precision-sustainable-ag/PlantMap3D-Hardware/Multi-Camera System Hardware/README.md

This directory will contain the 3D CAD for the multicamera system.
