precision-sustainable-ag/PlantMap3D-Hardware/System Management Board/SMB Power ON Flow Chart.drawio.png

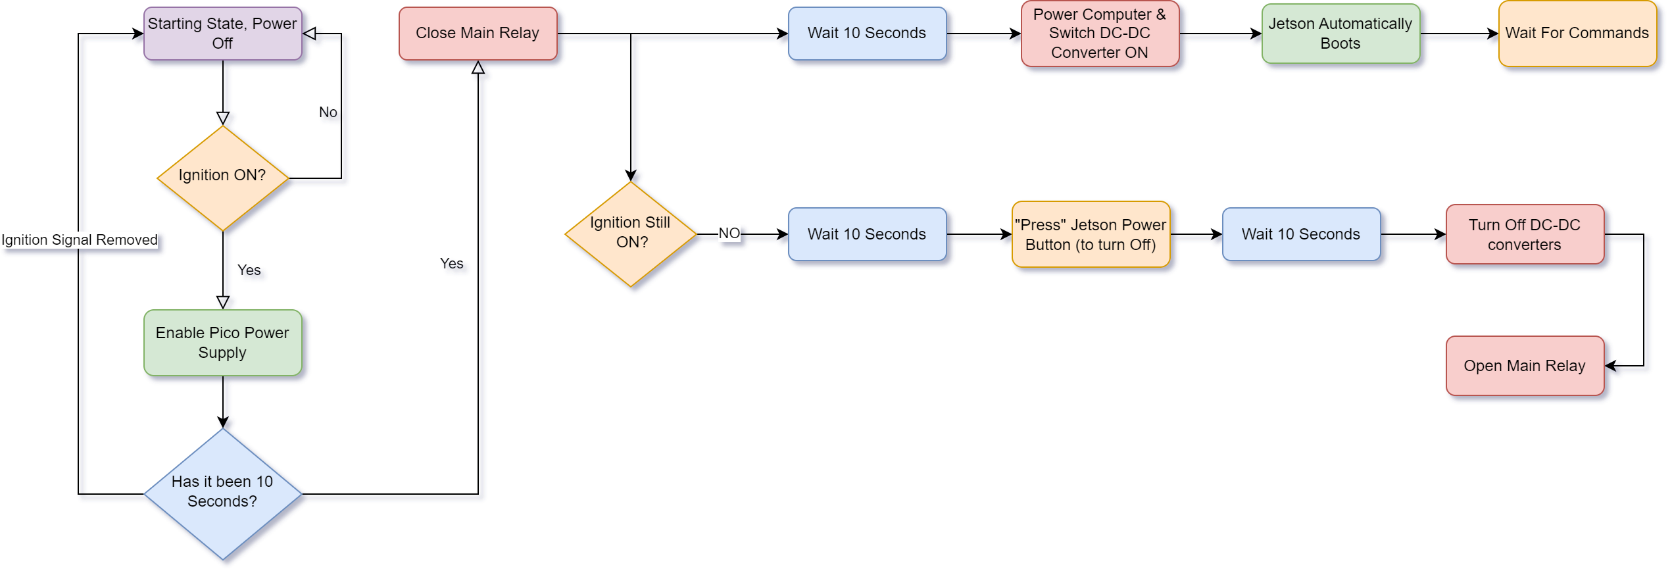
System Management Board/SMB Power ON Flow Chart.drawio.png
