precision-sustainable-ag/PlantMap3D-Hardware/System Management Board/PCB template.DXF

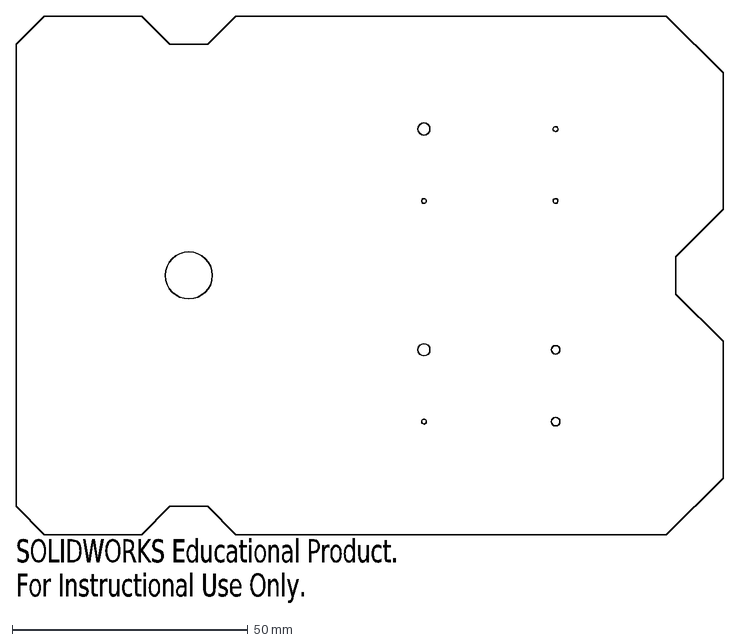
[picture p2: CAD file, 2024-04-09]
System Management Board/PCB template.DXF
SOLIDWORKS Educational Product.
For Instructional Use Only.
