precision-sustainable-ag/PlantMap3D-Hardware/System Management Board/Pico Power Stabilizer/outline template.DXF

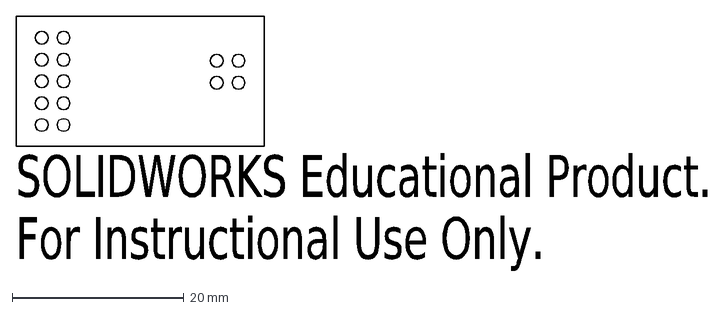
[picture p3: CAD file, 2024-12-06]
System Management Board/Pico Power Stabilizer/outline template.DXF
SOLIDWORKS Educational Product.
For Instructional Use Only.
