precision-sustainable-ag/PlantMap3D-Hardware/(list of files, cad)

Other CAD files:
System Management Board/3D CAD/I3A_STANDARD_ASM.SLDPRT
Multi-Camera System Hardware/(PSA-M063-Rev B) Enclosure Assem.SLDASM
Multi-Camera System Hardware/Brackets/Con Plate Jig.SLDASM
System Management Board/3D CAD/I7C4W008A120V-0C3-R.SLDASM
System Management Board/3D CAD/C_1210_3225Metric.SLDASM
System Management Board/3D CAD/HSOP-6J.SLDASM
Multi-Camera System Hardware/alignment jig.SLDASM
System Management Board/3D CAD/PinSocket_2x05_P2.54mm_Vertical.SLDASM
System Management Board/3D CAD/PinHeader_2x20_P2.54mm_Vertical.SLDASM
System Management Board/3D CAD/User Library-EE2-5NU.SLDASM
System Management Board/3D CAD/XG4A-4035--3DModel-STEP-273799.SLDASM
System Management Board/3D CAD/SOT-23.SLDASM
System Management Board/3D CAD/PinHeader_2x06_P2.54mm_Vertical.SLDASM
System Management Board/3D CAD/CUI_DEVICES_PJ-063BH.SLDASM
System Management Board/3D CAD/RES_3540_TEC.SLDASM
System Management Board/3D CAD/I3A4W008A033V-001-R.SLDASM
System Management Board/3D CAD/R_1206_3216Metric.SLDASM
System Management Board/3D CAD/D_SOD-123F.SLDASM
System Management Board/3D CAD/PinSocket_1x20_P2.54mm_Vertical.SLDASM
System Management Board/3D CAD/PinHeader_1x02_P2.54mm_Vertical.SLDASM
System Management Board/3D CAD/D_SMA.SLDASM
System Management Board/3D CAD/PinHeader_1x20_P2.54mm_Vertical.SLDASM
System Management Board/3D CAD/C_1206_3216Metric.SLDASM
System Management Board/3D CAD/50A relay.SLDASM
System Management Board/3D CAD/POWERDI5_DIO.SLDASM
System Management Board/3D CAD/User Library-ATO-ATC STANDARD BLADE FUSE.SLDASM
System Management Board/3D CAD/PinHeader_1x04_P2.54mm_Vertical.SLDASM
System Management Board/3D CAD/Relay_DPDT_Schrack-RT2-FormC_RM5mm.SLDASM
System Management Board/3D CAD/LED_1206_3216Metric.SLDASM
System Management Board/3D CAD/Universal Car Fuse Holder PCB v1.SLDASM
System Management Board/3D CAD/TSSOP-16_4.4x5mm_P0.65mm.SLDASM
System Management Board/Pico Power Stabilizer/Production Tooling/PinSocket_2x02_P2.54mm_Vertical_SMD.SLDASM
System Management Board/3D CAD/SC0915.SLDASM
System Management Board/3D CAD/Fuse_1206_3216Metric.SLDASM
System Management Board/Pico Power Stabilizer/Production Tooling/Pico Power Stabilizer.SLDASM
System Management Board/3D CAD/TL3305BF260QG.SLDASM
System Management Board/3D CAD/CP_Elec_10x12.6.SLDASM
System Management Board/Pico Power Stabilizer/Production Tooling/PinSocket_2x05_P2.54mm_Vertical_SMD.SLDASM
System Management Board/Pico Power Stabilizer/Production Tooling/R_0603_1608Metric.SLDASM
System Management Board/Pico Power Stabilizer/Production Tooling/PinHeader_2x02_P2.54mm_Vertical_SMD.SLDASM
System Management Board/Pico Power Stabilizer/Production Tooling/PinHeader_2x05_P2.54mm_Vertical_SMD.SLDASM
System Management Board/Pico Power Stabilizer/Production Tooling/jig Asm.SLDASM
System Management Board/Pico Power Stabilizer/Production Tooling/C_1210_3225Metric.SLDASM
System Management Board/Pico Power Stabilizer/Production Tooling/LED_0603_1608Metric.SLDASM
Mono Camera System Hardware/Oak-d CM4-POE Calibration Adapter Bracket.SLDPRT
Multi-Camera System Hardware/(PSA-0469-Rev B) Heatsink.STEP
Multi-Camera System Hardware/Brackets/(PSA-1318-Rev B) Backing Clamp Short.STEP
Part Manufacturing Files/10g switch hold down bracket.3MF
System Management Board/3D CAD/(PSA-M018-Rev A) System Management Board.SLDPRT
System Management Board/Pico Power Stabilizer/Pico Power Stabilizer.step
System Management Board/Pico Power Stabilizer/Production Tooling/PinHeader_2x02_P254mm_Vertical_SMD.SLDPRT
Multi-Camera System Hardware/(PSA-0105) Enclosure.SLDPRT
Multi-Camera System Hardware/Brackets/(PSA-1317-Rev B) Backing Clamp Long.STEP
Part Manufacturing Files/Lower Switch Mount.3MF
System Management Board/Pico Power Stabilizer/Production Tooling/Pico Power Stabilizer_pad_32.SLDPRT
Part Manufacturing Files/Peplink 42G Adapter.STEP
System Management Board/3D CAD/TSSOP_16_44x5mm_P065mm.SLDPRT
System Management Board/Pico Power Stabilizer/Production Tooling/Pico Power Stabilizer_pad_198.SLDPRT
Multi-Camera System Hardware/(PSA-1316-Rev A) Connector Plate.STEP
Part Manufacturing Files/Switch Bracket.3MF
System Management Board/Pico Power Stabilizer/Production Tooling/Pico Power Stabilizer_pad_9.SLDPRT
Multi-Camera System Hardware/(PSA-1320-Rev A) Heatsink Template.STEP
Part Manufacturing Files/Alignment jig.3MF
System Management Board/3D CAD/SC0915-13.SLDPRT
System Management Board/Pico Power Stabilizer/Production Tooling/Pico Power Stabilizer_pad_89.SLDPRT
Multi-Camera System Hardware/(PSA-0292-Rev A) Connector Plate Gasket.SLDPRT
Multi-Camera System Hardware/Brackets/(PSA-0749-Rev) Indicator Light Bracket.STEP
Part Manufacturing Files/Heatsink 266AS.STEP
System Management Board/3D CAD/LED_1206_3216Metric-7.SLDPRT
System Management Board/Pico Power Stabilizer/Production Tooling/Pico Power Stabilizer_track_4.SLDPRT
Multi-Camera System Hardware/(PSA-1319-Rev A) Connector Plate Template.STEP
Multi-Camera System Hardware/Brackets/(PSA-0754-Rev A) Din Rail Cable Clip.STEP
Part Manufacturing Files/Enclosure Drill Template.3MF
System Management Board/Pico Power Stabilizer/Production Tooling/Pico Power Stabilizer_pad_134.SLDPRT
Multi-Camera System Hardware/(PSA-0110-Rev B) Heat Spreader.SLDPRT
System Management Board/Pico Power Stabilizer/Production Tooling/Pico Power Stabilizer_pad_160.SLDPRT
Multi-Camera System Hardware/(PSA-0015) Jetson Dev Kit.SLDPRT
Multi-Camera System Hardware/Brackets/Din Rail Cable Clip.STEP
System Management Board/3D CAD/System Management Board_PCB.SLDPRT
System Management Board/Pico Power Stabilizer/Production Tooling/Pico Power Stabilizer_pad_171.SLDPRT
Multi-Camera System Hardware/(PSA-0746-Rev A) Manufactured Backing Plate.STEP
Multi-Camera System Hardware/Brackets/Con Plate Jig Leg.STEP
System Management Board/3D CAD/XG4A_4035.SLDPRT
System Management Board/Pico Power Stabilizer/Production Tooling/Pico Power Stabilizer_pad_81.SLDPRT
Multi-Camera System Hardware/(PSA-0703) POE Switch.SLDPRT
Multi-Camera System Hardware/Brackets/Jig Base.STEP
System Management Board/Pico Power Stabilizer/Production Tooling/Pico Power Stabilizer_pad_7.SLDPRT
Multi-Camera System Hardware/Brackets/dupont header clip.STEP
System Management Board/3D CAD/PinSocket_1x20_P254mm_Vertical.SLDPRT
System Management Board/Pico Power Stabilizer/Production Tooling/Pico Power Stabilizer_pad_102.SLDPRT
Multi-Camera System Hardware/(PSA-0720-Rev A) Switch Angle Bracket.SLDPRT
System Management Board/Pico Power Stabilizer/Production Tooling/Pico Power Stabilizer_pad_132.SLDPRT
Multi-Camera System Hardware/(PSA-0382) DIN Rail.SLDPRT
System Management Board/Pico Power Stabilizer/Production Tooling/Pico Power Stabilizer_pad_140.SLDPRT
Multi-Camera System Hardware/Laser Cut Mounting Plate.STEP
System Management Board/3D CAD/187CBA5A-D168-4B29-A226-42CC7D4E3C29.SLDPRT
System Management Board/Pico Power Stabilizer/Production Tooling/R_0603_1608Metric-1.SLDPRT
Multi-Camera System Hardware/2.5GBE POE SW Angle Bracket.STEP
System Management Board/Pico Power Stabilizer/Production Tooling/Pico Power Stabilizer_pad_169.SLDPRT
Multi-Camera System Hardware/BBv3 Connector Plate Gasket.STEP
System Management Board/3D CAD/PinHeader_1x04_P254mm_Vertical.SLDPRT
System Management Board/Pico Power Stabilizer/Production Tooling/Pico Power Stabilizer_pad_63.SLDPRT
Multi-Camera System Hardware/RF174-01RP1-05BJ3-0305.SLDPRT
System Management Board/3D CAD/C_1206_3216Metric-6.SLDPRT
System Management Board/Pico Power Stabilizer/Production Tooling/Pico Power Stabilizer_pad_57.SLDPRT
Multi-Camera System Hardware/PCB template.SLDPRT
System Management Board/3D CAD/R_1206_3216Metric-2.SLDPRT
System Management Board/Pico Power Stabilizer/Production Tooling/Pico Power Stabilizer_pad_98.SLDPRT
Multi-Camera System Hardware/Heatsink 165AS.SLDPRT
System Management Board/Pico Power Stabilizer/Production Tooling/Pico Power Stabilizer_pad_93.SLDPRT
System Management Board/Pico Power Stabilizer/Production Tooling/Pico Power Stabilizer_pad_42.SLDPRT
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
