precision-sustainable-ag/PlantMap3D-Hardware/Part Manufacturing Files/README.md

This directory will contain ready to use 2D and 3D manufacturing files, primarly for 3D printed and 2D routed parts.
