precision-sustainable-ag/PlantMap3D-Hardware/(threads)

Thread 2 (2024-03-18):

SIM Card Became Disconnected from PepWave Modem

alexrallen, 2024-03-18:
We observed an issue on the lake wheeler deployment where the pepwave stopped recognizing that a SIM card was connected.

A software reset was attempted within the web interface but that did not help.

The SIM card was then physically removed and reinstalled. After this the card was recognized again.

Filing this bug as a record of this issue, it is likely not actionable and we will not worry about it unless it reproduces again.

alexrallen, 2024-03-18:
Mark, you can close this as wontfix for now if you desire.

Closed 2024-03-19.

Thread 3 (2024-03-18):

Add RTC Batteries to Jetsons

alexrallen, 2024-03-18:
As of now, if the Jetson is powered off and does not have an active Internet connection at boot it fails to keep track of the current time.

This is important for time-stamping collected data and logs when under a flaky connection.

We can purchase a battery to be added to header "RTC_BATT" on the devkit board.

alexrallen, 2024-03-18:
I will identify a battery for purchase.

alexrallen, 2024-03-19:
@mtfunder This would work nicely (I don't recall how many Jetsons we have - pick your quantity based on your discretion, I linked a 10pk)

Rome Tech BIOS CMOS RTC Battery for Dell Alienware Alpha & Alienware Steam Machine Yellow Light Fix - CR2032CL-23-2 (10-Pack) https://a.co/d/dBacpJK

mtfunder, 2024-09-22:
As an update:

We ordered 30 of the above linked batteries but unfortunately the connection did not match up as expected.

Other options need to be investigated.

mtfunder, 2024-10-10:
Have not made progress on adding RTC for the AGX Orin carrier board in the multicam system.

This is the task for the Rafiki system: https://github.com/precision-sustainable-ag/Rafiki/issues/10

mtfunder, 2024-10-10:
I found this https://www.amazon.com/Rome-Tech-CMOS-Battery-Latitude/dp/B0BVN1NPJ2

from https://forums.developer.nvidia.com/t/rtc-clock-battery-for-the-orin-dev-kit/220939'

I think that may be the type for the AGX CB at least.

Closed 2025-02-24.

Thread 5 (2024-09-20):

Design new bracket for cellular modem

mtfunder, 2024-09-20:
**What's wrong**
- For PM3D multi installs we have used the L-bracket that is supplied with the cellular modem to mount it to the sprayer. However, this bracket is limited din the size of member it can be bolted to, and it has been determined it is not sturdy enough and may break over time due to fatigue from repeated bouncing of the modem.

**What done looks like**
- A complete part entry in PartsBox with a 3D .STEP files and a pdf drawing showing important dimensions.
- Cost estimate for 20 pcs from SendCutSend or OshPark.
- Source any additional hardware, like the screws that attach to the back of the modem. (The ones supplies are low quality and probably the wrong length.

**Additional Information**
- Design the bracket from stainless steel or powered coated aluminum or similar (heavy corrosion environment)
- 1/8" SS or 1/4" Al is probably sufficient
- Co-ordinate with installer to determine likely U-bolt sizes needed.

rbabcoc, 2025-01-27:
New bracket has been designed, ordered, delivered, tested, and packed for installer.

Thread 6 (2024-09-20):

External status light on CCM

mtfunder, 2024-09-20:
**What's wrong**
- Without opening the enclosure or checking to see if the Wi-Fi network is broadcasting, there isn't an easy way to tell if the system is currently powered on or running.

**What done looks like**
- A design and hardware selection for adding this light.
- All parts added to PartsBox
- Confluence page describing how it will work and how to install.
- Confirmation from the @alexrallen that embedded can add this feature on the software side.

**Additional Information**
- Be sure the external hardware is IP67 or better.
- Bright enough to see in daylight from the tractor cab.
- @Djyankencsu can help with figuring out how the SMB Pico could control the LED.
- Investigate if the SMB Aux header can be used for this.

cwnicho2, 2024-10-17:
**Best IP67 options so far**
https://veise2008.en.made-in-china.com/product/IZyAskMlZJGP/China-IP69K-Waterproof-Beacon-Warning-Lamp-Light-for-Emergency-Vehicle.html

https://www.grainger.com/product/ECCO-Beacon-Light-Flashing-Beacon-406A62

**My Favorite choice but its IP65 only**
https://shop.industrialemart.com/pdf/MS56M.pdf

cwnicho2, 2024-12-09:
See parts box project https://partsbox.com/psa/project/6981cejp9aky0ak03n6tyq2z8b/bom for the partslist

Closed 2025-02-21.

Thread 7 (2024-09-23):

Specify new parts for camera cable enhancement

mtfunder, 2024-09-23:
## Rationale ##
- The current way we manufacture the camera cables is somewhat cumbersome and has led to many defective connections.

## What done looks like ##
- Select a line of standard-length cables that will meet the needs for planned installations.
- Select the bulkhead connectors that will be used on the CCM side.
- Add all new parts to Partsbox.

## Stakeholders / Contacts ##
- @mtfunder

## Additional Information ##
- We may look into female to male extension cables as well.
- Should be outdoor rated (UV /water/ chemical exposure).

mtfunder, 2024-09-23:
This is looking to be a bit painful. There are not that many suppliers of these cable assemblies that actually keep them in stock. And those that do may not have enough for our needs.

Further, 15 meters is the longest common length, which would require an extension cable in many installs.

Closed 2025-02-21.

Thread 8 (2024-09-23):

Modify Modular Connector Plate design for new camera cable connectors

mtfunder, 2024-09-23:
## Rationale ##
- The connector plate will need to be re-designed to fit the new M12 X-code connectors selected here: https://github.com/precision-sustainable-ag/PlantMap3D-Hardware/issues/7
- Also, the GPS connector holes should be added to the CAD so they do not need to be manually drilled.

## What done looks like ##
- CAD file and price quote uploaded to PartsBox, added to project.

## Stakeholders / Contacts ##
- @mtfunder

## Additional Information ##
- Use new BB mounting hole pattern

Closed 2025-02-24.

Thread 9 (2024-09-23):

Create procedure for tightening / installing M12 cables correctly

mtfunder, 2024-09-23:
## Rationale ##
- We have had issues with eh consistency of installed M12 connections on the Pm3D multi system and elsewhere.
- This has resulted in some connection failures, particularly camera cables.

## What done looks like ##
- A basic procedure for installing the connectors written on Confluence.
- Any tools specified added to PartsBox.

## Stakeholders / Contacts ##
- @mtfunder
- @rbabcoc

## Additional Information ##
- See what the industry standard is, some kind of torque wrench?

mtfunder, 2024-09-23:
This looks like a decent tool to try out: https://www.digikey.com/en/products/detail/weidm%C3%BCller/1920000000/3994560

Notably this one will work with round connectors.

Thread 14 (2024-10-04):

[PO]: Custom Heatsink Order

mtfunder, 2024-10-04:
Place an order with sales@heatsinkonline.com for 10 more of the same heatsink we ordered with them last time.

There is an existing email thread @mtfunder can forward you.

You will need a quote, however this will be well under $5K so you do not need a formal PO.

##Partsbox Link##

https://partsbox.com/psa/parts/5g5nmzmda6kacbr57mfy0sk6aq

kldriver, 2024-10-17:
@mtfunder If you send me the email thread for the exact heatsink, I can get things moving on this purchase

mtfunder, 2024-11-04:
@kldriver I replied and CCd you to the email.

Closed 2024-12-10.

Thread 16 (2024-11-04):

Develop a Deployable Camera Flash Controller Unit

cwnicho2, 2024-11-04:
## Rationale ##
- The previous implementation is simple, and works as intended but is a prototype quality device

## What done looks like ##
- Electronics assembly robust and repeatable [consider making a PCB]
- Housing meets the weatherproofing expectations of the benchbot system [IP67 typically]
- All new parts added to PartsBox
- Confluence page updated to reflect the design decisions.

## Stakeholders / Contacts ##
- @mtfunder

Confluence:
https://precision-sustainable-ag.atlassian.net/wiki/spaces/HE/pages/771096604/Camera+Flash+Handler+Board

Thread 17 (2025-04-28):

SMBV0.3 Input Voltage Bug

cwnicho2, 2025-04-28:
**Describe the bug**
When testing the system management board [SMBV0.3] at higher supply voltage 24V, the system was not able to properly boot. The system was believed to be tolerant of higher input voltages and this was discovered by accident.

**To Reproduce**
Steps to reproduce the behavior:
1. Connect J1 and the keyswitch trigger to the the SMB using a DC power supply
2. Set the supply voltage to 24V
3. Torn on the output of the power supply and observe the SMB behavior

**Expected behavior**
The SMB should be tolerant of the higher input voltage

**Additional context**
There is a cable made for testing the SMB with the DC power supply available in the lab space. I recomend testing a series of voltages from 12v onward to see at what voltage the behavior destabilizes

Thread 18 (2025-04-28):

Future SMB revisions

cwnicho2, 2025-04-28:
## Rationale ##
- These are improvements/changes that can be made that didn't make it into V0.3

## What done looks like ##
- Update KiCad files
- Update Partsbox SMB project: Designators, BOM, etc

## Specific Details ##
- There are 1210 and 1206 footprints for the same capacaitor smd these can be consolidated into one single size. This apparantly is an artifact from a previous supply chain issue
-  Remove all instances of the EE-2NU signal relay being used so that is never accidentally populated
-  The most recent branch is relay stick fix, we should make clear which version future engineers should work/fork from
