precision-sustainable-ag/PlantMap3D-Hardware/Part Manufacturing Files/Heatsink 266AS Tapped Hole Locations.pdf

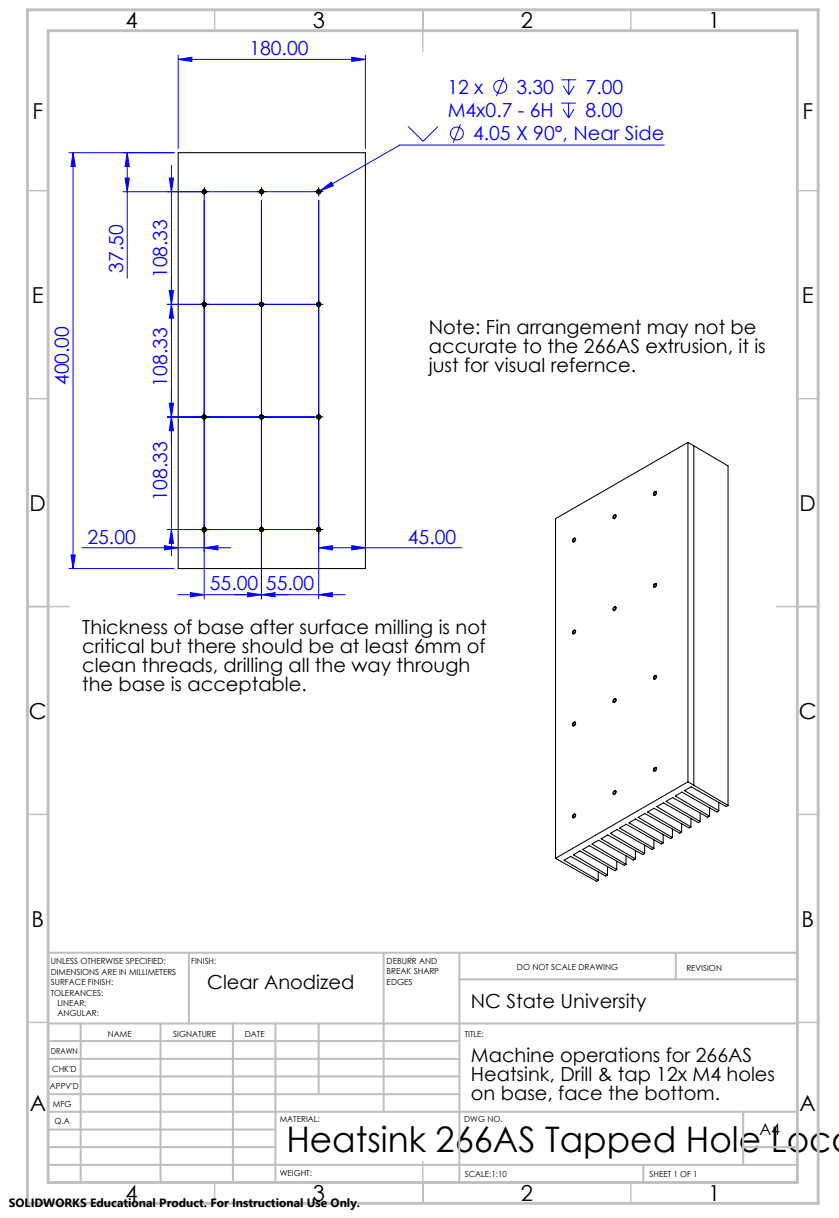
[picture p6: page 1]
M4x0.7 - 6H 8.00 4.05 X 90°, Near Side; Clear Anodized; FINISH:; DEBURR AND; BREAK SHARP; DO NOT SCALE DRAWING; REVISION; SCALE:1:10; SHEET 1 OF 1

Note: Fin arrangement may not be
accurate to the 266AS extrusion, it is
just for visual refernce.

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

UNLESS OTHERWISE SPECIFIED:
DIMENSIONS ARE IN MILLIMETERS
SURFACE FINISH:
TOLERANCES:
LINEAR:
ANGULAR:

NC State University

NAME | SIGNATURE | DATE | | | | TITLE: Machine operations for 266AS Heatsink, Drill & tap 12x M4 holes on base, face the bottom.

DRAWN
CHK'D
APPV'D
MFG
Q.A | | | | MATERIAL: | DWG NO. | A4

Heatsink 266AS Tapped Hole Locations

SOLIDWORKS Educational Product. For Instructional Use Only.
