precision-sustainable-ag/PlantMap3D-Hardware/System Management Board/System Management Board.pdf

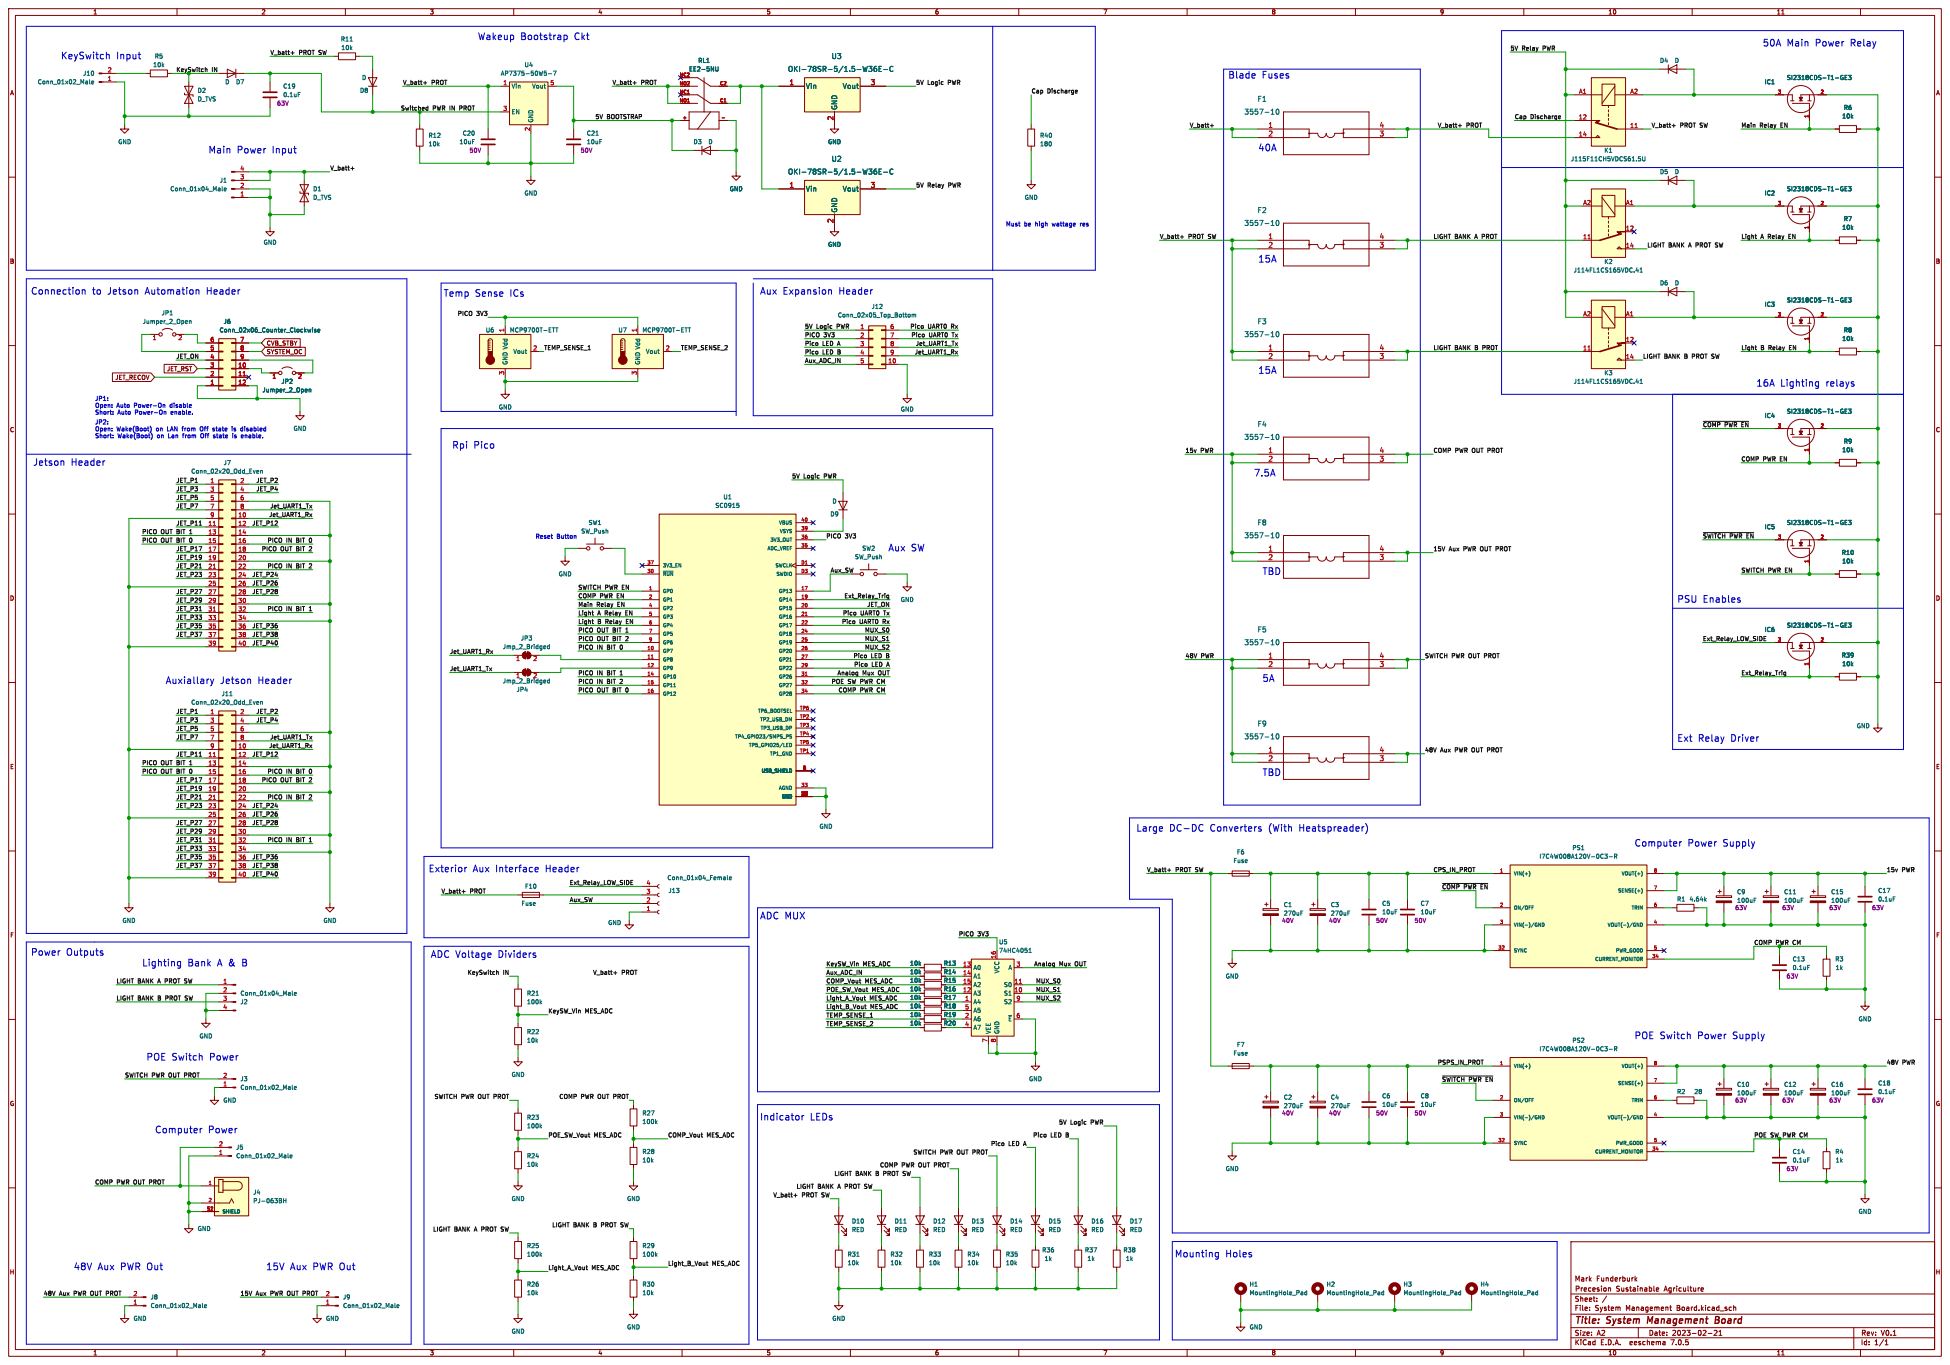
[picture p7: page 1]

2 Vout 3 GND GND GND U3 OKI-78SR-5/1.5-W36E-C

Switched PWR IN PROT

~{COMP PWR EN} LIGHT BANK A PROT SW

3 U7 MCP9700T-ETT SW1 SW_Push GND
JP2: Open: Wake(Boot) on LAN from Off state is disabled Short: Wake(Boot) on Lan from Off state is enable. Computer Power

LIGHT BANK B PROT SW

COMP PWR OUT PROT

JET_P11 PICO OUT BIT 0 PICO OUT BIT 1

15V Aux PWR OUT PROT

PICO IN BIT 2 PICO OUT BIT 0

~{COMP PWR EN} 48V Aux PWR OUT PROT COMP_Vout MES_ADC

Large DC-DC Converters (With Heatspreader)

Exterior Aux Interface Header

MUX_S1 MUX_S0 Analog Mux OUT SWITCH PWR OUT PROT

LIGHT BANK A PROT SW

SWITCH PWR OUT PROT

POE SW PWR CM

48V Aux PWR OUT PROT
