precision-sustainable-ag/PlantMap3D-Hardware/Part Manufacturing Files/Enclosure Drill Template.pdf

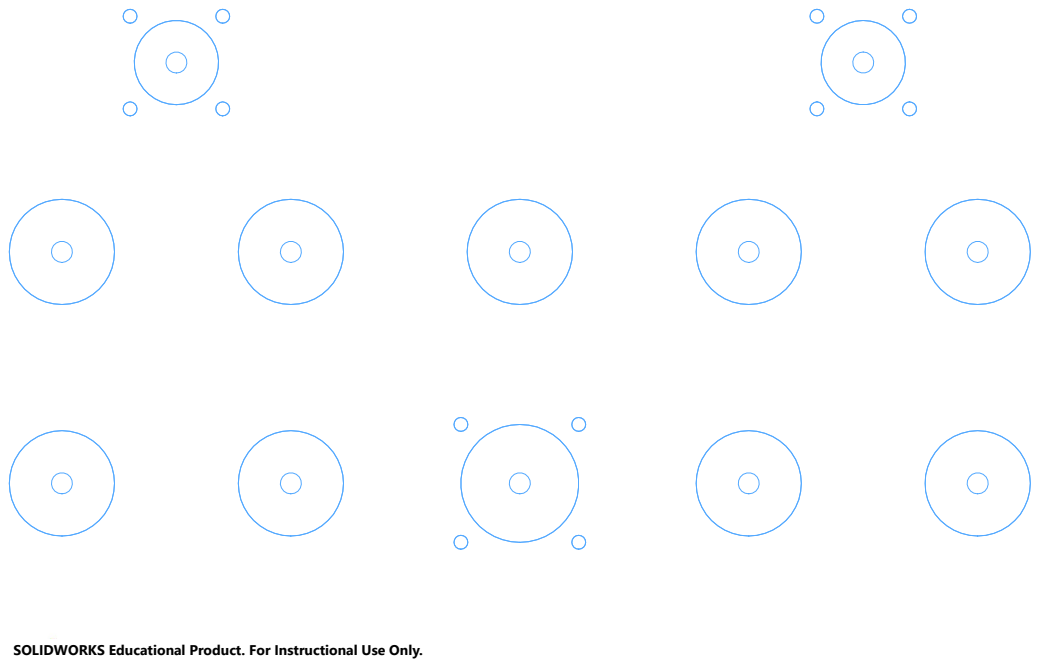
[picture p8: page 1]

SOLIDWORKS Educational Product. For Instructional Use Only.
