precision-sustainable-ag/PlantMap3D-Hardware/System Management Board/Pico Power Stabilizer/Pico Power Stabilizer.kicad_pcb

## KiCad design System Management Board/Pico Power Stabilizer/Pico Power Stabilizer.kicad_pcb (2024-12-06)

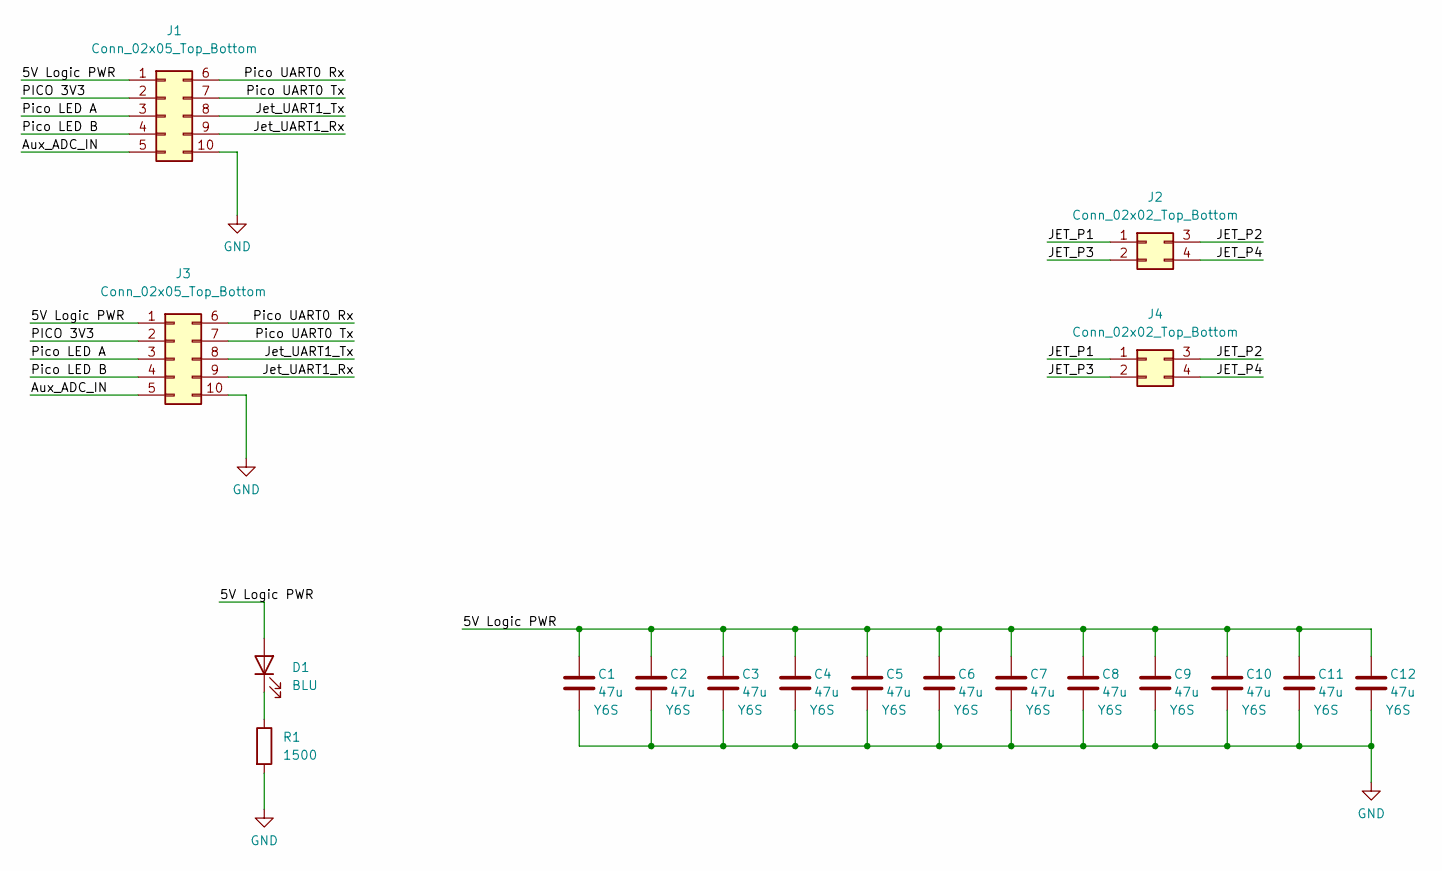
[picture p9: schematic Pico Power Stabilizer.kicad_sch]

Parts:
C1, C2, C3, C4, C5, C6, C7, C8, C9, C10, C11, C12: 47u; C_1210_3225Metric
D1: BLU; LED_0603_1608Metric
J1: Conn_02x05_Top_Bottom; PinHeader_2x05_P2.54mm_Vertical_SMD
J2: Conn_02x02_Top_Bottom; PinHeader_2x02_P2.54mm_Vertical_SMD
J3: Conn_02x05_Top_Bottom; PinSocket_2x05_P2.54mm_Vertical_SMD
J4: Conn_02x02_Top_Bottom; PinSocket_2x02_P2.54mm_Vertical_SMD
R1: 1500; R_0603_1608Metric

Connections:
/5V Logic PWR: C1.1, C2.1, C3.1, C4.1, C5.1, C6.1, C7.1, C8.1, C9.1, C10.1, C11.1, C12.1, D1.2 (A), J1.1, J3.1
/Aux_ADC_IN: J1.5, J3.5
/JET_P1: J2.1, J4.1
/JET_P2: J2.3, J4.3
/JET_P3: J2.2, J4.2
/JET_P4: J2.4, J4.4
/Jet_UART1_Rx: J1.9, J3.9
/Jet_UART1_Tx: J1.8, J3.8
/PICO 3V3: J1.2, J3.2
/Pico LED A: J1.3, J3.3
/Pico LED B: J1.4, J3.4
/Pico UART0 Rx: J1.6, J3.6
/Pico UART0 Tx: J1.7, J3.7
GND: C1.2, C2.2, C3.2, C4.2, C5.2, C6.2, C7.2, C8.2, C9.2, C10.2, C11.2, C12.2, J1.10, J3.10, R1.2
unnamed: D1.1 (K), R1.1

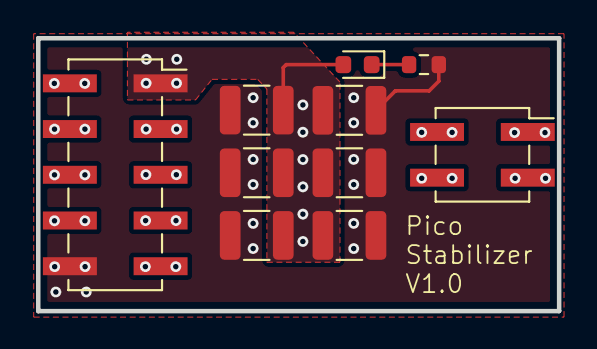
[picture p10: board Pico Power Stabilizer.kicad_pcb from above]

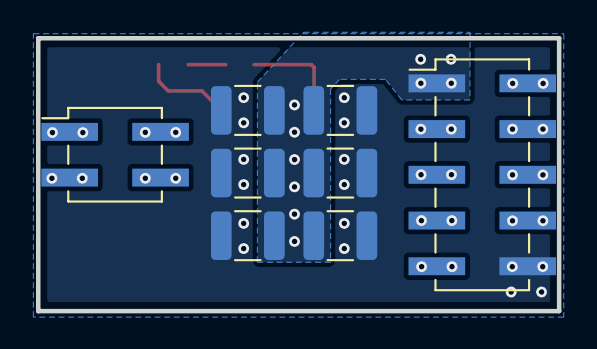
[picture p11: board Pico Power Stabilizer.kicad_pcb from below]

Board: 2 copper layers, 28.9 x 15.2 mm, 18 parts (8 on the bottom side), 15 nets.
