precision-sustainable-ag/PlantMap3D-Hardware/System Management Board/System Management Board.kicad_pcb

## KiCad design System Management Board/System Management Board.kicad_pcb (2024-11-21)

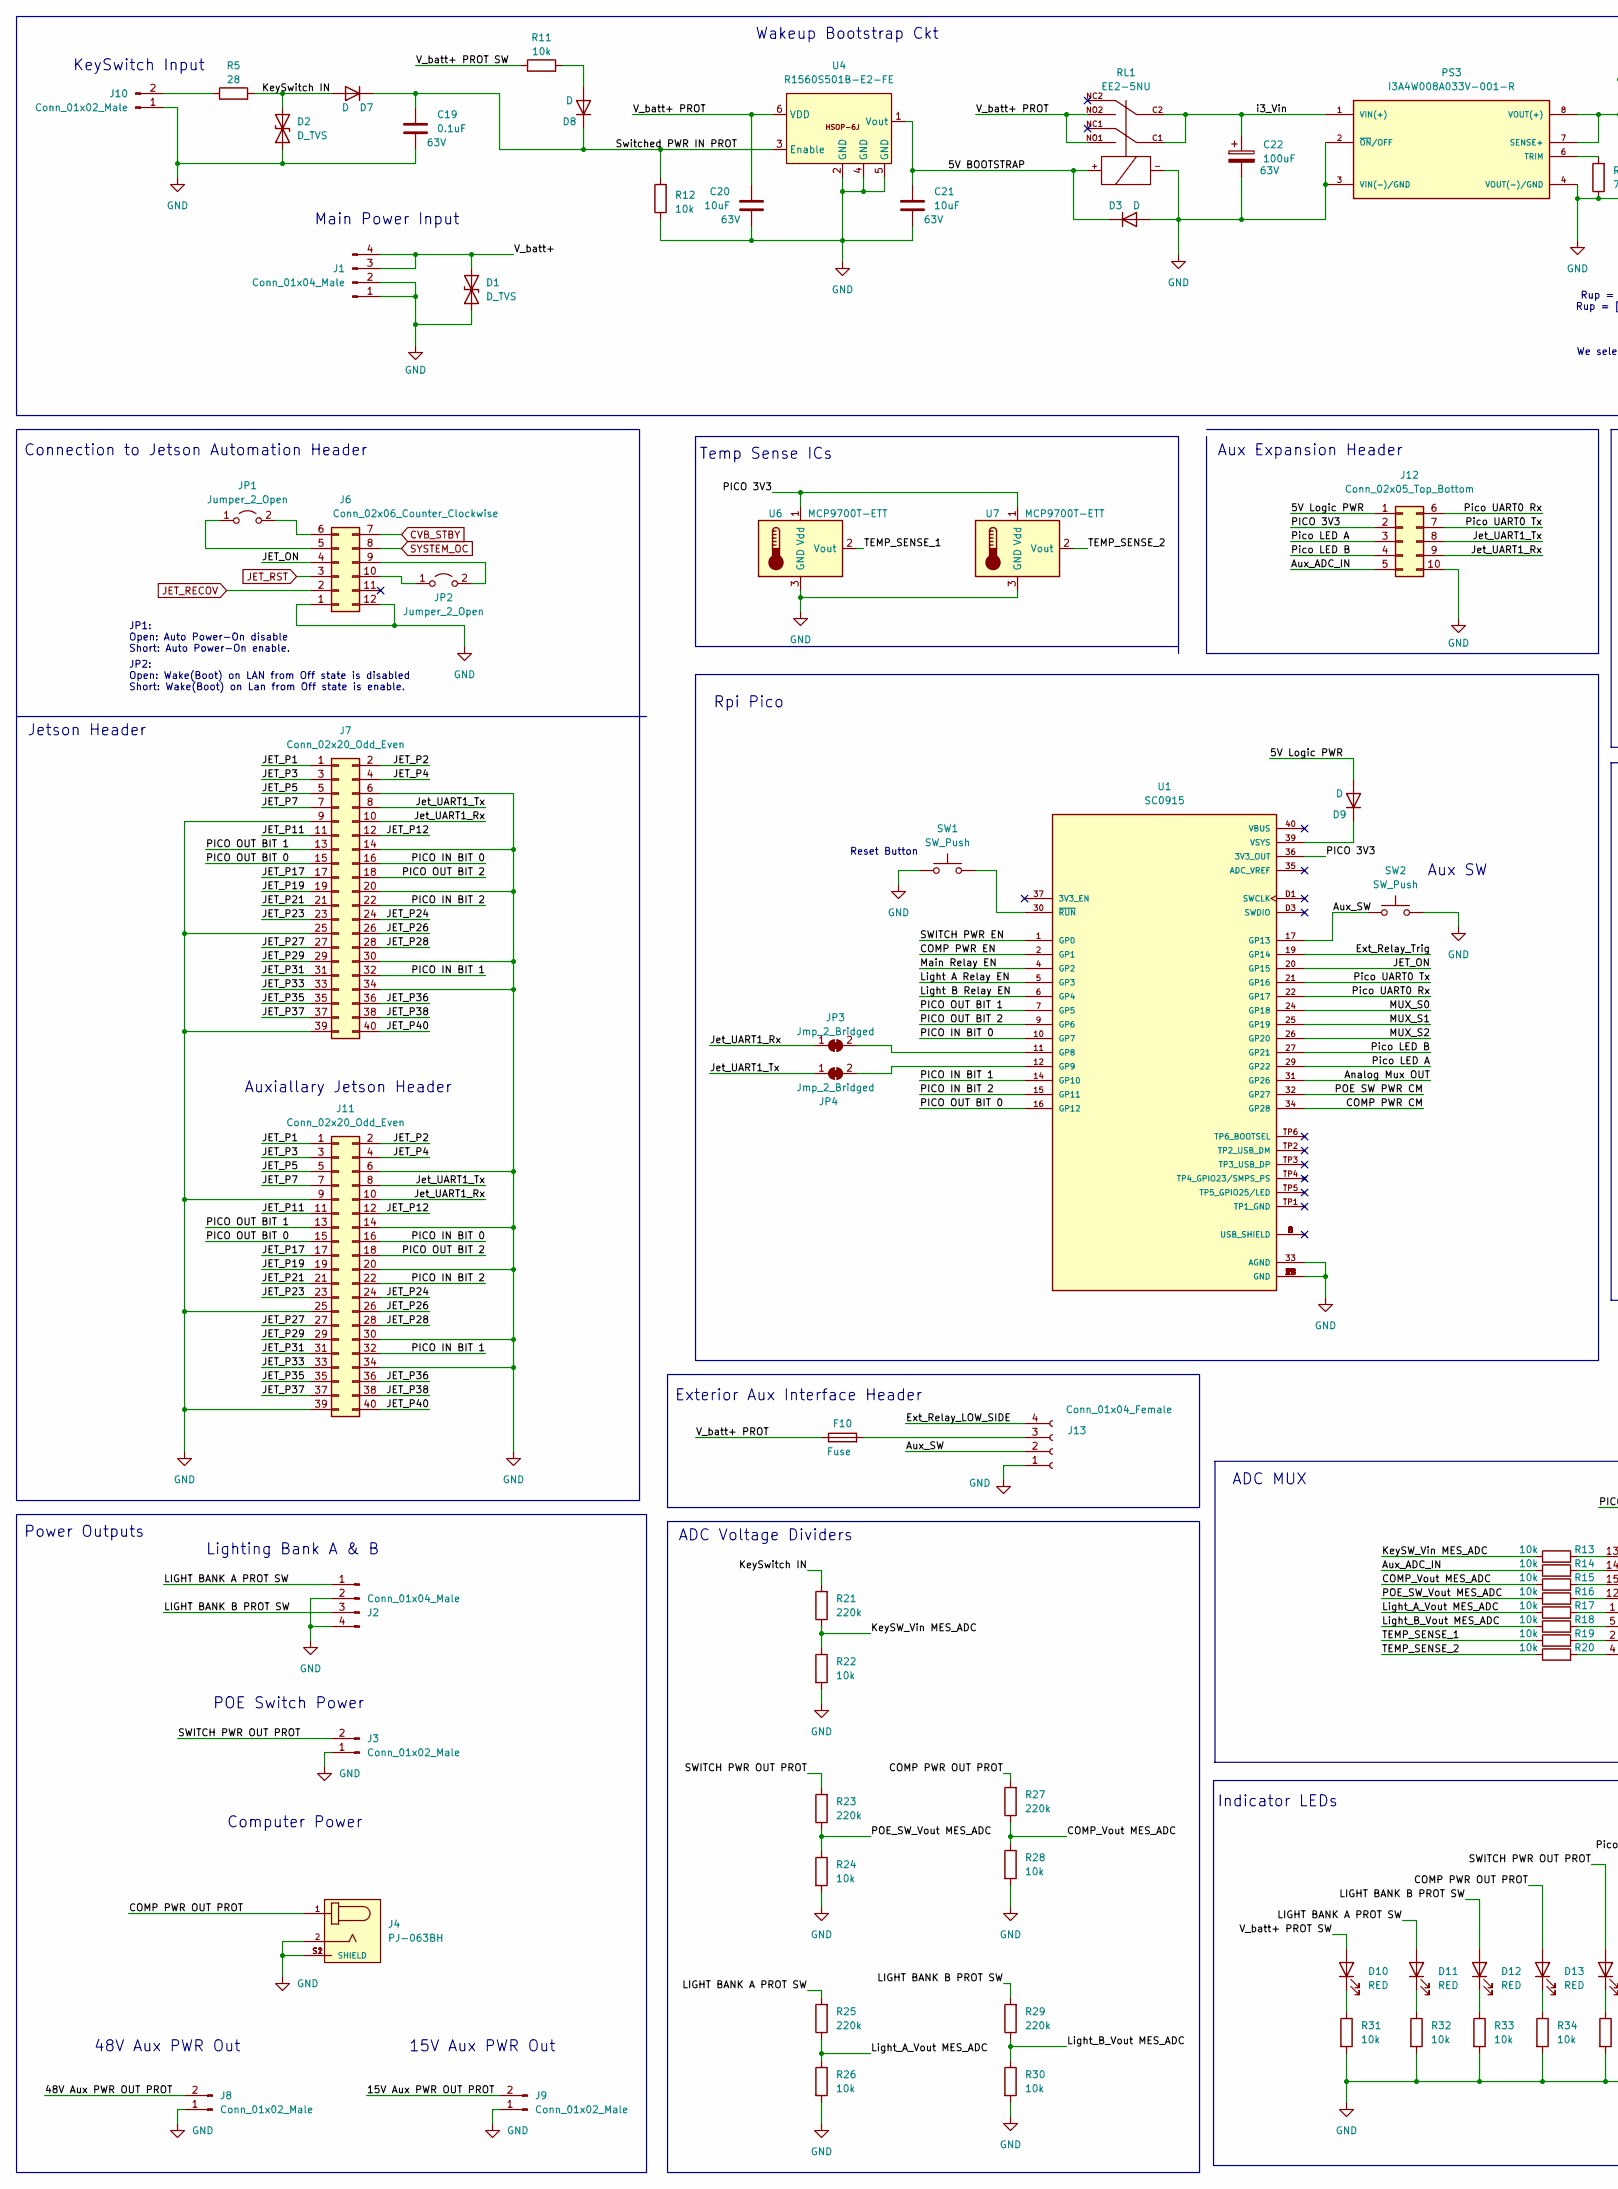
[picture p12: schematic System Management Board.kicad_sch, part in row 1, column 1]

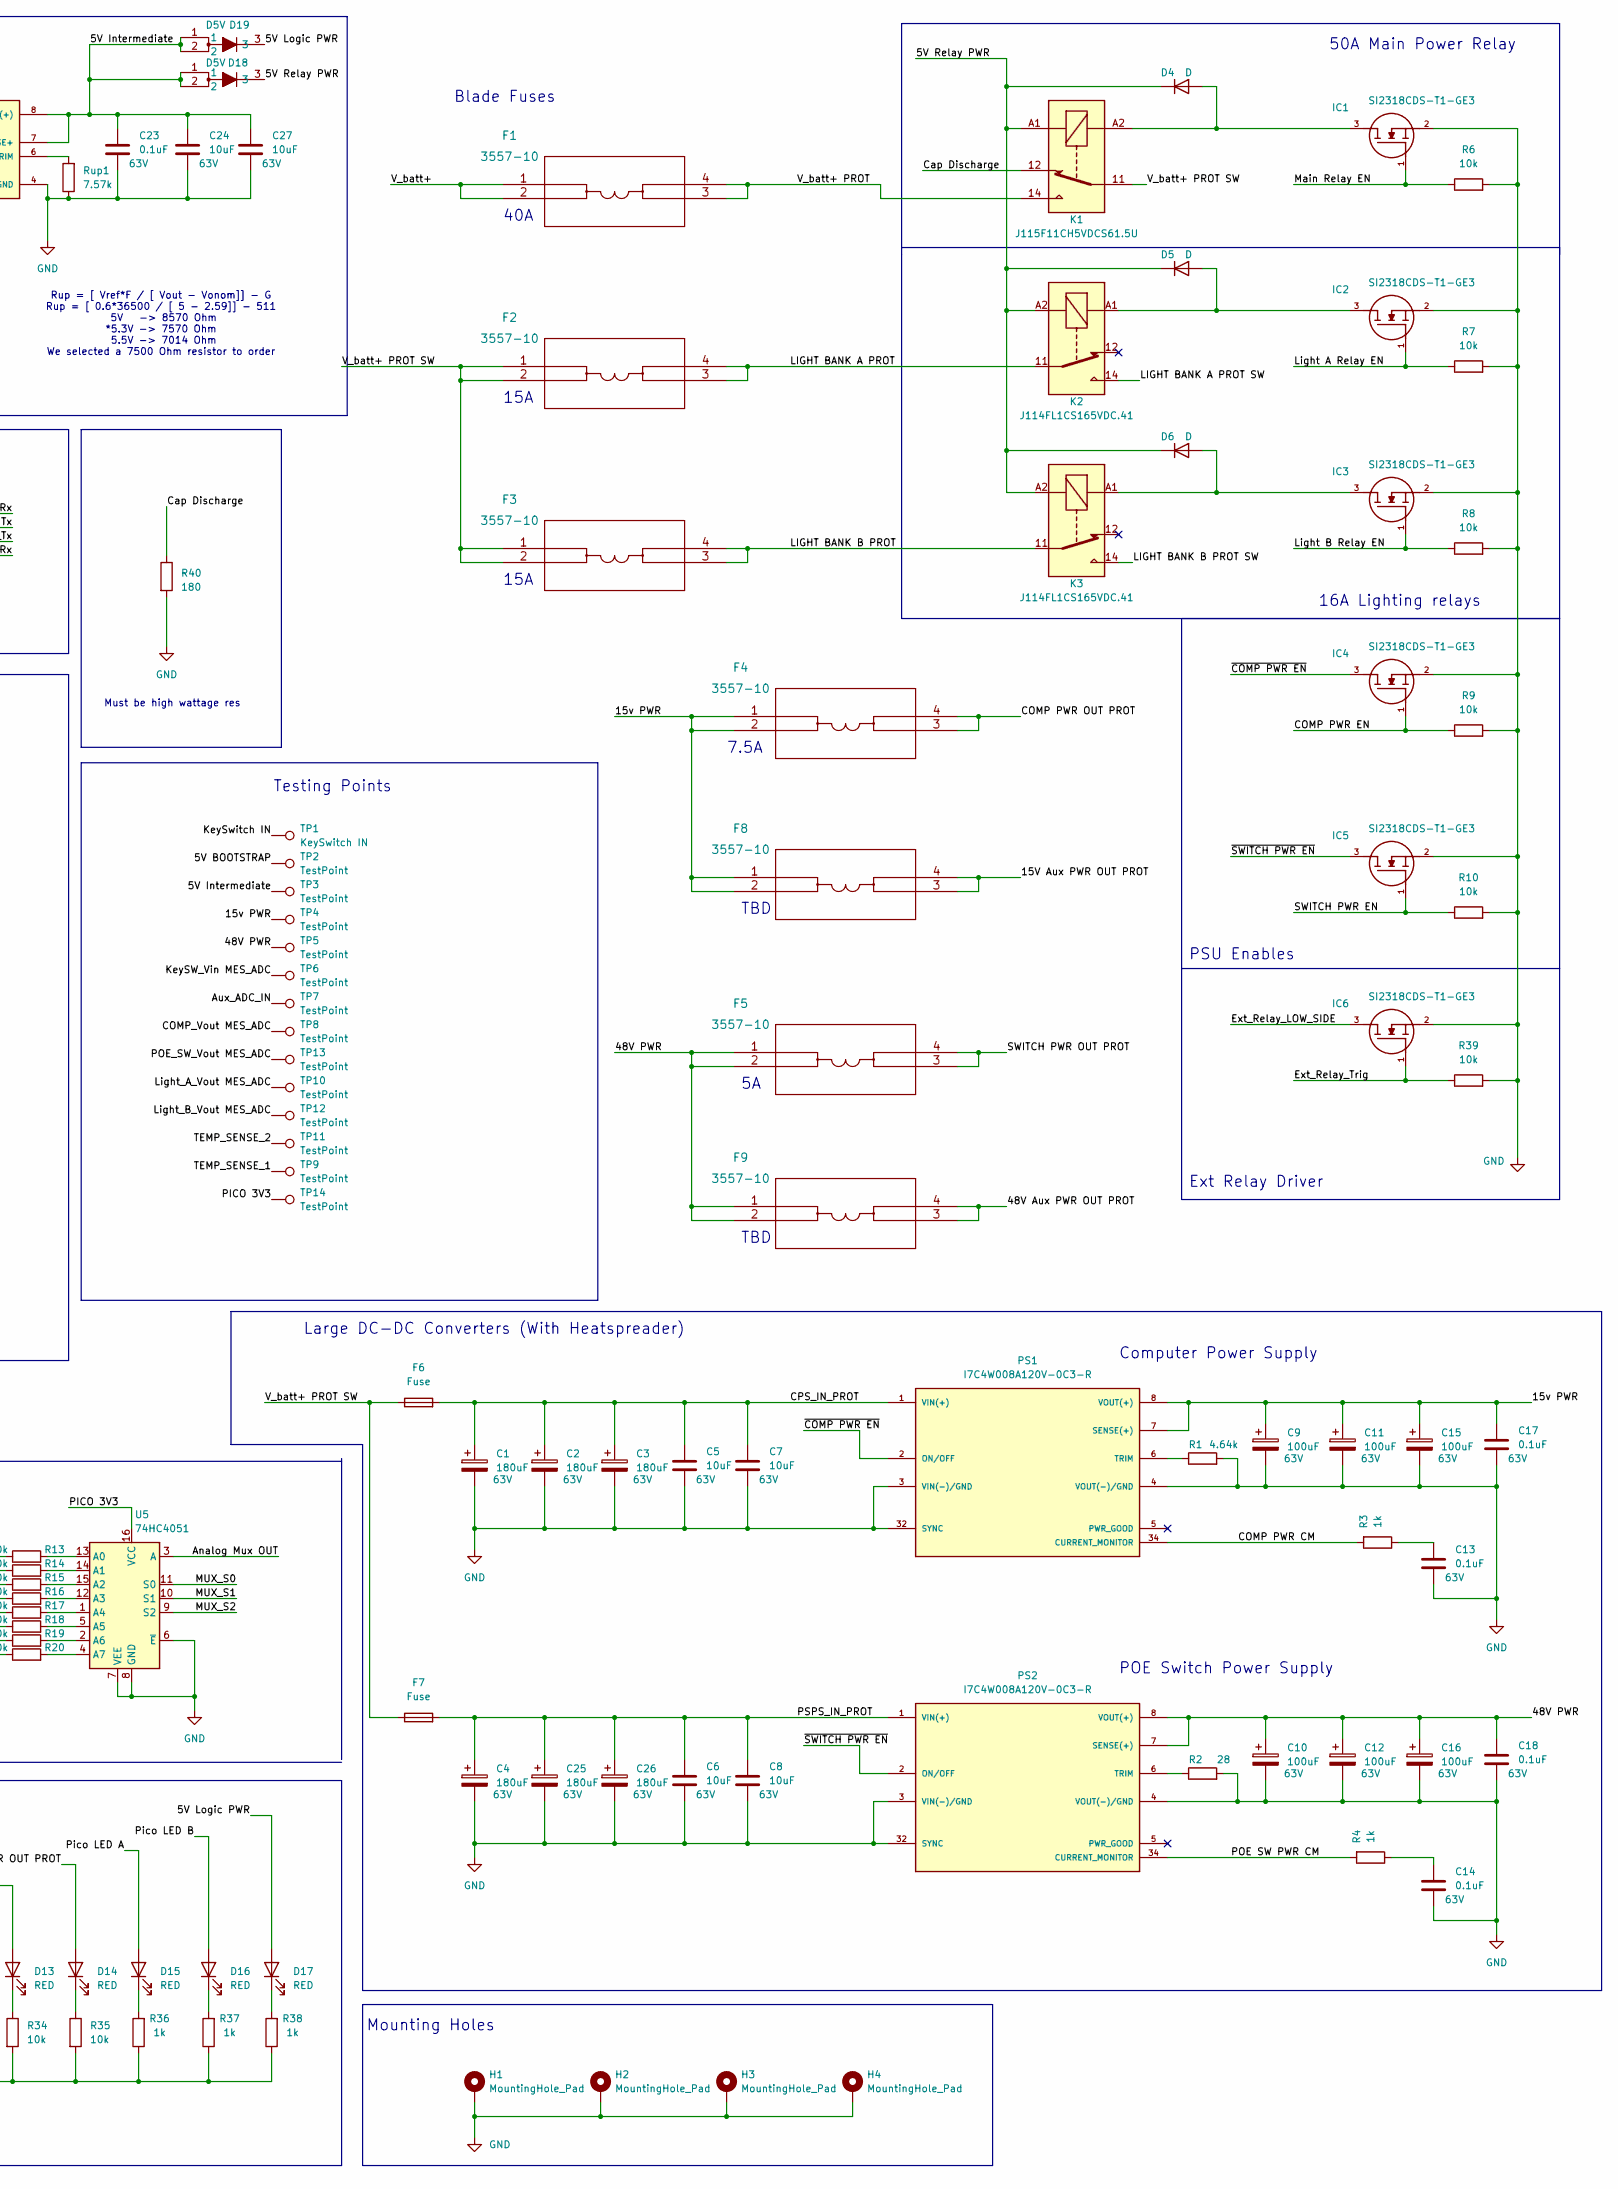
[picture p13: schematic System Management Board.kicad_sch, part in row 1, column 2]

Parts:
C1, C2, C3, C4, C25, C26: 180uF; CP_Elec_10x12.6; Voltage 63V
C5, C6, C7, C8, C20, C21, C24, C27: 10uF; C_1210_3225Metric; Voltage 63V
C9, C10, C11, C12, C15, C16, C22: 100uF; CP_Elec_10x12.6; Voltage 63V
C13, C14, C19, C23: 0.1uF; C_1206_3216Metric; Voltage 63V
C17, C18: 0.1uF; C_1210_3225Metric; Voltage 63V
D1, D2: D_TVS; D_SMA
D3, D4, D5, D6, D7, D8, D9: D; D_SOD-123F
D10, D11, D12, D13, D14, D15, D16, D17: RED; LED_1206_3216Metric
D18, D19: D5V; POWERDI5_DIO
F1, F2, F3, F4, F5, F8, F9: 3557-10
F6, F7: Fuse; FUSC9830X318N
F10: Fuse; Fuse_1206_3216Metric_Pad1.42x1.75mm_HandSolder
H1, H2, H3, H4: MountingHole_Pad; MountingHole_3.2mm_M3_DIN965_Pad
IC1, IC2, IC3, IC4, IC5, IC6: SI2318CDS-T1-GE3; SOT95P237X112-3N; MANUFACTURER_PART_NUMBER SI2318CDS-T1-GE3; MOUSER_PART_NUMBER 781-SI2318CDS-T1-GE3
J1, J2: Conn_01x04_Male; 1924321
J3, J8, J9, J10: Conn_01x02_Male; 1843606
J4: PJ-063BH; CUI_PJ-063BH
J6: Conn_02x06_Counter_Clockwise; PinHeader_2x06_P2.54mm_Vertical
J7: Conn_02x20_Odd_Even; PinHeader_2x20_P2.54mm_Horizontal
J11: Conn_02x20_Odd_Even; PinHeader_2x20_P2.54mm_Vertical
J12: Conn_02x05_Top_Bottom; PinSocket_2x05_P2.54mm_Vertical
J13: Conn_01x04_Female; PinHeader_1x04_P2.54mm_Vertical
JP1, JP2: Jumper_2_Open; PinHeader_1x02_P2.54mm_Vertical
JP3, JP4: Jmp_2_Bridged; SolderJumper-2_P1.3mm_Bridged_Pad1.0x1.5mm
K1: J115F11CH5VDCS61.5U; Relay_SPDT_RAYEX-L90S
K2, K3: J114FL1CS165VDC.41; Big Pads - Relay_SPDT_Schrack-RT1-16A-FormC_RM5mm
PS1, PS2: I7C4W008A120V-0C3-R; CONV_I7C4W008A120V-0C3-R
PS3: I3A4W008A033V-001-R; CONV_I3A4W008A033V-001-R
R1: 4.64k; R_1206_3216Metric
R2, R5: 28; R_1206_3216Metric
R3, R4, R36, R37, R38: 1k; R_1206_3216Metric
R6, R7, R8, R9, R10, R11, R12, R13, R14, R15, R16, R17, R18, R19, R20, R22, R24, R26, R28, R30, R31, R32, R33, R34, R35, R39: 10k; R_1206_3216Metric
R21, R23, R25, R27, R29: 220k; R_1206_3216Metric
R40: 180; RES_3540_TEC
RL1: EE2-5NU
Rup1: 7.57k; R_1206_3216Metric
SW1, SW2: SW_Push; SW_TL3305BF260QG
TP1: KeySwitch IN; TestPoint_Pad_D1.0mm
TP2, TP3, TP4, TP5, TP6, TP7, TP8, TP9, TP10, TP11, TP12, TP13, TP14: TestPoint; TestPoint_Pad_D1.0mm
U1: SC0915; MODULE_SCO915_Custom_HeaderStyle; PARTREV 1.6
U4: R1560S501B-E2-FE; HSOP-6J
U5: 74HC4051; TSSOP-16_4.4x5mm_P0.65mm
U6, U7: MCP9700T-ETT; SOT-23

Connections:
/5V BOOTSTRAP: C21.1, D3.1 (K), RL1.+, TP2.1, U4.1 (Vout)
/5V Intermediate: C23.1, C24.1, C27.1, D18.1, D18.2, D19.1, D19.2, PS3.7 (SENSE+), PS3.8 (VOUT(+)), TP3.1
/5V Logic PWR: D9.2 (A), D17.2 (A), D19.3, J12.1
/5V Relay PWR: D4.1 (K), D5.1 (K), D6.1 (K), D18.3, K1.A1, K2.A2, K3.A2
/15V Aux PWR OUT PROT: F8.3, F8.4, J9.2
/15v PWR: C9.1, C11.1, C15.1, C17.1, F4.1, F4.2, F8.1, F8.2, PS1.7 (SENSE(+)), PS1.8 (VOUT(+)), TP4.1
/48V Aux PWR OUT PROT: F9.3, F9.4, J8.2
/48V PWR: C10.1, C12.1, C16.1, C18.1, F5.1, F5.2, F9.1, F9.2, PS2.7 (SENSE(+)), PS2.8 (VOUT(+)), TP5.1
/Analog Mux OUT: U1.31 (GP26), U5.3 (A)
/Aux_ADC_IN: J12.5, R14.1, TP7.1; also elsewhere on the board
/Aux_SW: J13.2, SW2.1, U1.17 (GP13)
/COMP PWR CM: PS1.34 (CURRENT_MONITOR), R3.2, U1.34 (GP28)
/COMP PWR EN: IC4.1, R9.1, U1.2 (GP1)
/COMP PWR OUT PROT: D13.2 (A), F4.3, F4.4, J4.1, R27.2
/COMP_Vout MES_ADC: R15.1, R27.1, R28.1, TP8.1; also elsewhere on the board
/CPS_IN_PROT: C1.1, C2.1, C3.1, C5.1, C7.1, F6.2, PS1.1 (VIN(+))
/Cap Discharge: K1.12, R40.1
/Ext_Relay_LOW_SIDE: IC6.3, J13.4
/Ext_Relay_Trig: IC6.1, R39.1, U1.19 (GP14)
/JET_ON: J6.4, U1.20 (GP15)
/JET_P1: J7.1, J11.1
/JET_P2: J7.2, J11.2
/JET_P3: J7.3, J11.3
/JET_P4: J7.4, J11.4
/JET_P5: J7.5, J11.5
/JET_P7: J7.7, J11.7
/JET_P11: J7.11, J11.11
/JET_P12: J7.12, J11.12
/JET_P17: J7.17, J11.17
/JET_P19: J7.19, J11.19
/JET_P21: J7.21, J11.21
/JET_P23: J7.23, J11.23
/JET_P24: J7.24, J11.24
/JET_P26: J7.26, J11.26
/JET_P27: J7.27, J11.27
/JET_P28: J7.28, J11.28
/JET_P29: J7.29, J11.29
/JET_P31: J7.31, J11.31
/JET_P33: J7.33, J11.33
/JET_P35: J7.35, J11.35
/JET_P36: J7.36, J11.36
/JET_P37: J7.37, J11.37
/JET_P38: J7.38, J11.38
/JET_P40: J7.40, J11.40
/Jet_UART1_Rx: J7.10, J11.10, J12.9, JP3.1 (A)
/Jet_UART1_Tx: J7.8, J11.8, J12.8, JP4.1 (A)
/KeySW_Vin MES_ADC: R13.1, R21.1, R22.1, TP6.1; also elsewhere on the board
/KeySwitch IN: D2.2 (A2), D7.2 (A), R5.2, R21.2, TP1.1
/LIGHT BANK A PROT: F2.3, F2.4, K2.11
/LIGHT BANK A PROT SW: D11.2 (A), J2.1, K2.14, R25.2
/LIGHT BANK B PROT: F3.3, F3.4, K3.11
/LIGHT BANK B PROT SW: D12.2 (A), J2.3, K3.14, R29.2
/Light A Relay EN: IC2.1, R7.1, U1.5 (GP3)
/Light B Relay EN: IC3.1, R8.1, U1.6 (GP4)
/Light_A_Vout MES_ADC: R17.1, R25.1, R26.1, TP10.1; also elsewhere on the board
/Light_B_Vout MES_ADC: R18.1, R29.1, R30.1, TP12.1; also elsewhere on the board
/MUX_S0: U1.24 (GP18), U5.11 (S0)
/MUX_S1: U1.25 (GP19), U5.10 (S1)
/MUX_S2: U1.26 (GP20), U5.9 (S2)
/Main Relay EN: IC1.1, R6.1, U1.4 (GP2)
/PICO 3V3: J12.2, TP14.1, U1.36 (3V3_OUT), U5.16 (VCC), U6.1 (Vdd), U7.1 (Vdd); also elsewhere on the board
/PICO IN BIT 0: J7.16, J11.16, U1.10 (GP7)
/PICO IN BIT 1: J7.32, J11.32, U1.14 (GP10)
/PICO IN BIT 2: J7.22, J11.22, U1.15 (GP11)
/PICO OUT BIT 0: J7.15, J11.15, U1.16 (GP12)
/PICO OUT BIT 1: J7.13, J11.13, U1.7 (GP5)
/PICO OUT BIT 2: J7.18, J11.18, U1.9 (GP6)
/POE SW PWR CM: PS2.34 (CURRENT_MONITOR), R4.2, U1.32 (GP27)
/POE_SW_Vout MES_ADC: R16.1, R23.1, R24.1, TP13.1; also elsewhere on the board
/PSPS_IN_PROT: C4.1, C6.1, C8.1, C25.1, C26.1, F7.2, PS2.1 (VIN(+))
/Pico LED A: D15.2 (A), J12.3, U1.29 (GP22)
/Pico LED B: D16.2 (A), J12.4, U1.27 (GP21)
/Pico UART0 Rx: J12.6, U1.22 (GP17)
/Pico UART0 Tx: J12.7, U1.21 (GP16)
/SWITCH PWR EN: IC5.1, R10.1, U1.1 (GP0)
/SWITCH PWR OUT PROT: D14.2 (A), F5.3, F5.4, J3.2, R23.2
/Switched PWR IN PROT: C19.1, D7.1 (K), D8.1 (K), R12.2, U4.3 (Enable)
/TEMP_SENSE_1: R19.1, TP9.1, U6.2 (Vout); also elsewhere on the board
/TEMP_SENSE_2: R20.1, TP11.1, U7.2 (Vout); also elsewhere on the board
/V_batt+: D1.2 (A2), F1.1, F1.2, J1.3, J1.4
/V_batt+ PROT: C20.1, F1.3, F1.4, F10.1, K1.14, RL1.NO1, RL1.NO2, U4.6 (VDD)
/V_batt+ PROT SW: D10.2 (A), F2.1, F2.2, F3.1, F3.2, F6.1, F7.1, K1.11, R11.1
/i3_Vin: C22.1, PS3.1 (VIN(+)), RL1.C1, RL1.C2
/~COMP PWR EN: IC4.3, PS1.2 (ON/OFF)
/~SWITCH PWR EN: IC5.3, PS2.2 (ON/OFF)
CVB_STBY: J6.7
GND: C1.2, C2.2, C3.2, C4.2, C5.2, C6.2, C7.2, C8.2, C9.2, C10.2, C11.2, C12.2, C13.2, C14.2, C15.2, C16.2, C17.2, C18.2, C19.2, C20.2, C21.2, C22.2, C23.2, C24.2, C25.2, C26.2, C27.2, D1.1 (A1), D2.1 (A1), D3.2 (A), H1.1, H2.1, H3.1, H4.1, IC1.2, IC2.2, IC3.2, IC4.2, IC5.2, IC6.2, J1.1, J1.2, J2.2, J2.4, J3.1, J4.2, J4.S1 (SHIELD), J4.S2 (SHIELD), J6.1, J6.12, J7.6, J7.9, J7.14, J7.20, J7.25, J7.30, J7.34, J7.39, J8.1, J9.1, J10.1, J11.6, J11.9, J11.14, J11.20, J11.25, J11.30, J11.34, J11.39, J12.10, J13.1, PS1.3 (VIN(-)/GND), PS1.4 (VOUT(-)/GND), PS1.32 (SYNC), PS2.3 (VIN(-)/GND), PS2.4 (VOUT(-)/GND), PS2.32 (SYNC), PS3.2 (~ON/OFF), PS3.3 (VIN(-)/GND), PS3.4 (VOUT(-)/GND), R1.2, R2.2, R6.2, R7.2, R8.2, R9.2, R10.2, R12.1, R22.2, R24.2, R26.2, R28.2, R30.2, R31.2, R32.2, R33.2, R34.2, R35.2, R36.1, R37.1, R38.1, R39.2, R40.2, RL1.-, Rup1.1, SW1.1, SW2.2, U1.3 (GND), U1.8 (GND), U1.13 (GND), U1.18 (GND), U1.23 (GND), U1.28 (GND), U1.33 (AGND), U1.38 (GND), U1.D2 (GND), U4.2 (GND), U4.4 (GND), U4.5 (GND), U5.6 (~E), U5.7 (VEE), U5.8 (GND), U6.3 (GND), U7.3 (GND)
JET_RECOV: J6.2
JET_RST: J6.3
unnamed: C13.1, R3.1
unnamed: C14.1, R4.1
unnamed: D4.2 (A), IC1.3, K1.A2
unnamed: D5.2 (A), IC2.3, K2.A1
unnamed: D6.2 (A), IC3.3, K3.A1
unnamed: D8.2 (A), R11.2
unnamed: D9.1 (K), U1.39 (VSYS)
unnamed: D10.1 (K), R31.1
unnamed: D11.1 (K), R32.1
unnamed: D12.1 (K), R33.1
unnamed: D13.1 (K), R34.1
unnamed: D14.1 (K), R35.1
unnamed: D15.1 (K), R36.2
unnamed: D16.1 (K), R37.2
unnamed: D17.1 (K), R38.2
unnamed: J6.5, JP1.1 (A)
unnamed: J6.6, JP1.2 (B)
unnamed: J6.9, JP2.2 (B)
unnamed: J6.10, JP2.1 (A)
unnamed: J10.2, R5.1
unnamed: F10.2, J13.3
unnamed: JP3.2 (B), U1.11 (GP8)
unnamed: JP4.2 (B), U1.12 (GP9)
unnamed: PS1.6 (TRIM), R1.1
unnamed: PS2.6 (TRIM), R2.1
unnamed: PS3.6 (TRIM), Rup1.2
unnamed: SW1.2, U1.30 (~RUN)
unnamed: R13.2, U5.13 (A0)
unnamed: R14.2, U5.14 (A1)
unnamed: R15.2, U5.15 (A2)
unnamed: R16.2, U5.12 (A3)
unnamed: R17.2, U5.1 (A4)
unnamed: R18.2, U5.5 (A5)
unnamed: R19.2, U5.2 (A6)
unnamed: R20.2, U5.4 (A7)
SYSTEM_OC: J6.8

Notes on the sheet:
KeySwitch Input
TBD
48V Aux PWR Out
Power Outputs
Rup = [ Vref*F / [ Vout - Vonom]] - G Rup = [ 0.6*36500 / [ 5 - 2.59]] - 511 5V -> 8570 Ohm *5.3V -> 7570 Ohm 5.5V -> 7014 Ohm We selected a 7500 Ohm resistor to order
Auxiallary Jetson Header
Testing Points
40A
50A Main Power Relay
Computer Power
15A
Large DC-DC Converters (With Heatspreader)
Computer Power Supply
JP1: Open: Auto Power-On disable Short: Auto Power-On enable.
Main Power Input
Indicator LEDs
Blade Fuses
POE Switch Power Supply
Rpi Pico
Must be high wattage res
16A Lighting relays
Temp Sense ICs
POE Switch Power
Exterior Aux Interface Header
7.5A
Connection to Jetson Automation Header
JP2: Open: Wake(Boot) on LAN from Off state is disabled Short: Wake(Boot) on Lan from Off state is enable.
Lighting Bank A & B
ADC Voltage Dividers
Jetson Header
Wakeup Bootstrap Ckt
Mounting Holes
Ext Relay Driver
ADC MUX
Aux SW
15V Aux PWR Out
Reset Button
PSU Enables
Aux Expansion Header

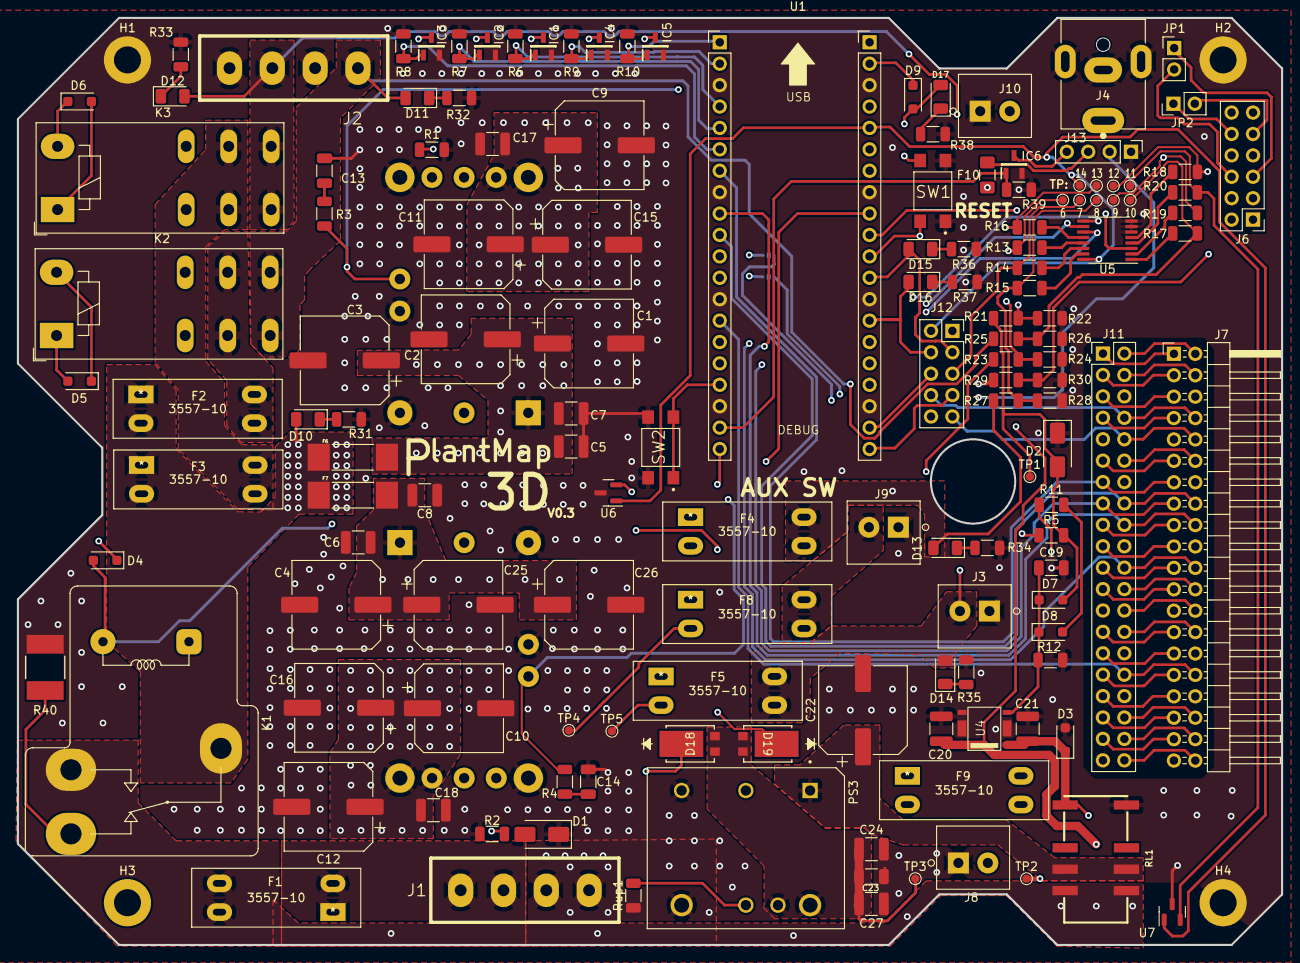
[picture p14: board System Management Board.kicad_pcb from above]

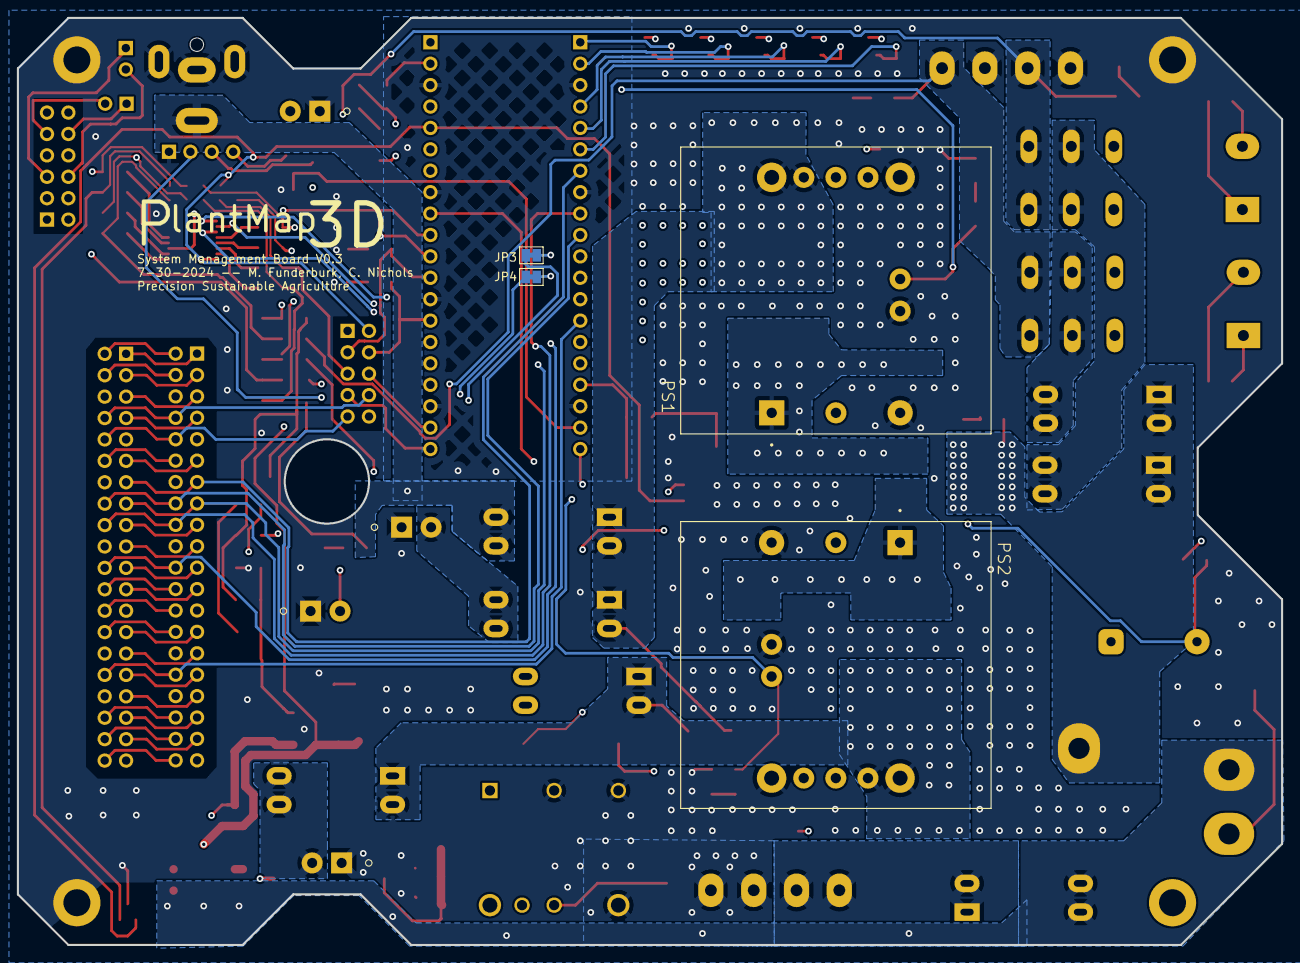
[picture p15: board System Management Board.kicad_pcb from below]

Board: 4 copper layers, 150.0 x 110.0 mm, 151 parts (4 on the bottom side), 121 nets.

Other parts of the board:
6, 7, 8, 9, 10, 11, 12, 13, 14: TestPoint; TestPoint_Pad_D1.0mm

Their connections:
/Aux_ADC_IN: 7.1; also elsewhere on the board
/COMP_Vout MES_ADC: 8.1; also elsewhere on the board
/KeySW_Vin MES_ADC: 6.1; also elsewhere on the board
/Light_A_Vout MES_ADC: 10.1; also elsewhere on the board
/Light_B_Vout MES_ADC: 12.1; also elsewhere on the board
/PICO 3V3: 14.1; also elsewhere on the board
/POE_SW_Vout MES_ADC: 13.1; also elsewhere on the board
/TEMP_SENSE_1: 9.1; also elsewhere on the board
/TEMP_SENSE_2: 11.1; also elsewhere on the board
