precision-sustainable-ag/PlantMap3D-Hardware/(commit log)

2023-01-05 inital kicad files added and gitignore
    [System Management Board.kicad_pcb, System Management Board.kicad_sch]
2023-01-05 Added folders and files for 3D CAD parts
    [Enclosure Assem.SLDASM, Enclosure Box.SLDPRT, Mounting plate.SLDPRT, heat spreader.SLDPRT, jetson dev kit no fan.SLDPRT, tep150wi_3d_drawing.stp]
2023-01-05 Added Enclosure Drill Template
    [Enclosure Drill Template.3MF, Enclosure Drill Template.DXF]
2023-01-05 Started playing around with layout and mounting of SMB in Enclosure
    [Enclosure Assem.SLDASM, System Management Board.SLDASM, System Management Board.kicad_pcb, System Management Board.kicad_sch, System Management Board.step]
2023-01-06 Added heatsink and modified mounting hole positions, the manufac files match what was sent to heat sink vendor
    [Enclosure Assem.SLDASM, Heatsink 165AS.SLDPRT, Heatsink 266AS Tapped Hole Locations.SLDDRW, Heatsink 266AS.SLDPRT, Heatsink 266AS.STEP, heat spreader.SLDPRT]
2023-01-14 worked on PCB template for SMB
    [Enclosure Assem.SLDASM, PCB template.SLDPRT, heat spreader.SLDPRT]
2023-01-14 Fixed solidworks brainmelt from last commit and moved PCb template into Kicad
    [Enclosure Assem.SLDASM, PCB template.DXF, PCB template.SLDPRT, System Management Board.SLDASM, System Management Board.kicad_pcb, System Management Board.kicad_sch, System Management Board.step, System Management Board.step.SLDPRT]
2023-01-14 Worked on importing KiCad parts and major componet layout
    [1717035.SLDASM, 1717035_01.SLDPRT, 1717035_02.SLDPRT, 1717035_03.SLDPRT, 1717035_04.SLDPRT, 1717035_05.SLDPRT, Enclosure Assem.SLDASM, System Management Board.kicad_pcb]
2023-01-17 Added 3D printable bracket for Mono camera calibration system
    [1717035.SLDASM, 1717035_01.SLDPRT, 1717035_02.SLDPRT, 1717035_03.SLDPRT, 1717035_04.SLDPRT, 1717035_05.SLDPRT, Oak-d CM4-POE Calibration Adapter Bracket.3MF, Oak-d CM4-POE Calibration Adapter Bracket.SLDPRT]
2023-01-18 Added more parts to SMB KiCad, worked on schematic and power supplies
    [System Management Board.kicad_pcb, System Management Board.kicad_sch]
2023-01-20 Finished heatspreader and sent to Xometry, solidified postion of DC-DC converters and mounting holes on SMB PCB
    [0678L9250-02.step.SLDASM, 1843606.step.SLDASM, 1911981.step.SLDASM, 1924321.step.SLDASM, 50A relay.step.SLDASM, COMPOUND-10.step.SLDPRT, COMPOUND-12.step.SLDPRT, COMPOUND-13.step.SLDPRT]
2023-01-24 Added aux outputs and worked on routing for high current traces
    [System Management Board.kicad_pcb, System Management Board.kicad_sch]
2023-01-27 general SMB schmeatic work
    [System Management Board.kicad_sch]
2023-02-07 Removed GPS module, added GPIO connections to headder, added aux jetson header
    [System Management Board.kicad_pcb, System Management Board.kicad_sch]
2023-02-21 Added keyswitch auto power ON logic and other power switching signals
    [System Management Board.kicad_sch]
2023-02-21 Finished all high current connections
    [System Management Board.kicad_pcb, System Management Board.kicad_sch]
2023-02-21 Added analog mux ckt and placed componets
    [System Management Board.kicad_pcb, System Management Board.kicad_sch]
2023-02-22 completed and organized schematic
    [System Management Board.kicad_pcb, System Management Board.kicad_sch]
2023-02-22 layout complete, routing nearly done
    [System Management Board.kicad_pcb, System Management Board.kicad_sch]
2023-02-23 Completed SMB and generated GERBER data
    [0678L9250-02.SLDASM, 0678L9250-02.step.SLDASM, 1843606.SLDASM, 1843606.step.SLDASM, 1911981.SLDASM, 1911981.step.SLDASM, 1924321.SLDASM, 1924321.step.SLDASM]
2023-03-10 added html BOM
2023-04-07 added pdf schematic
    [Alignment jig.3MF, Alignment jig.SLDPRT, System Management Board.kicad_sch, alignment jig.SLDASM]
2023-04-07 added flow chart for power on function
2023-05-09 ranadom stuff over the past few weeks
    [0678L9250-02.SLDASM, 1843606.SLDASM, 1911981.SLDASM, 1924321.SLDASM, 50A relay.SLDASM, COMPOUND.SLDPRT, COMPOUND_2.SLDPRT, COMPOUND_3.SLDPRT]
2023-05-09 Changed R12 from 100k to 10k
    [System Management Board.kicad_sch]
2023-05-09 Added Bleeddown funtion to main sswithced power
    [System Management Board.kicad_sch]
2023-05-09 added teardrops on traces and fixed some DRC warnings
    [System Management Board.kicad_pcb]
2023-05-09 Started adding thermal releifs and making pads larger, about 50% done
    [System Management Board.kicad_pcb, System Management Board.kicad_sch]
2023-05-09 Changed DC-DC current mesuremnt to anolog pin in schematic
    [System Management Board.kicad_sch]
2023-05-15 Compleated refactoring schematic changes into Layout
    [System Management Board.kicad_sch]
2023-06-19 Added Firmware for System Management Board
2023-06-20 Improved AUX Switch Press Handling
2023-06-23 PCB as uploaded to mfg
2023-08-14 Updated ibom for New Board
2023-09-22 Working prototype of firmware and updated gitignore
2023-10-07 Forgot to Commit Updated Pin Assignments
2023-10-27 Updated Firmware for Voltage Change and I-Monitor
2023-10-27 Fixed Voltage read Res Values
    [1 5 Pipe to Box adapter Metal.SLDDRW, 1 5 Pipe to Box adapter Metal.SLDPRT, 1 5 Pipe to Box adapter Metal.STEP, 1 5 Pipe to Box adapter.3mf, 1 5 Pipe to Box adapter.SLDPRT, 1 5 Pipe to Box adapter.STEP, 10g switch hold down bracket.3MF, 10g switch hold down bracket.SLDPRT]
2023-10-27 Working Firmware for PCB Update
2023-10-27 Added Input Pin Sequence Handling
2023-10-27 Increased ADC read speed
2023-11-03 Added UART and Function Descriptions
2023-11-03 Expanded Jetson test Method
2024-03-07 Update to UART Pins
2024-04-09 initial commit of THT Pi Pico Board
    [Enclosure Drill Template.DXF, PCB template.DXF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]
2024-04-10 fixed a missing connection, route spacing between THT, and 3D model compatibility
    [System Management Board.kicad_pcb]
2024-04-10 route optimization and via reduction
    [System Management Board.kicad_pcb]
2024-07-02 forty eight volt complaint parts, routing not finished
    [System Management Board.kicad_pcb, System Management Board.kicad_sch]
2024-07-03 routed and swapped for higher voltages
    [System Management Board.kicad_pcb, System Management Board.kicad_sch]
2024-07-05 reviewed and also chenged some footprints for out of stock component
    [System Management Board.kicad_pcb, System Management Board.kicad_sch]
2024-07-05 22uF replaced with 2x10uF like previously done
    [System Management Board.kicad_pcb, System Management Board.kicad_sch]
2024-07-08 double checked and ready for building
    [System Management Board.kicad_pcb, System Management Board.kicad_sch]
2024-07-19 improved trace widths and diode sizing
    [System Management Board.kicad_pcb]
2024-07-19 minor changes naming or routing
    [System Management Board.kicad_sch]
2024-07-22 ready for review from superiors. 3D models made more complete
    [System Management Board.kicad_pcb, System Management Board.kicad_sch]
2024-07-23 Fixed high power fill zones
    [System Management Board.kicad_pcb]
2024-07-23 more zone optimizations
    [System Management Board.kicad_pcb]
2024-07-30 Pushing most recent, no significant changes
    [System Management Board.kicad_pcb, System Management Board.kicad_sch]
2024-10-11 testing points added
    [System Management Board.kicad_pcb, System Management Board.kicad_sch]
2024-10-14 pushing all test pt mods
    [System Management Board.kicad_pcb, System Management Board.kicad_sch]
2024-10-15 minor improvements
    [System Management Board.kicad_pcb]
2024-10-25 significant amount of testing points added
    [System Management Board.kicad_pcb, System Management Board.kicad_sch]
2024-11-04 removed J5, moved J9 for clearance, removed global flags
    [System Management Board.kicad_pcb, System Management Board.kicad_sch]
2024-11-20 repaired computer power out zone
    [System Management Board.kicad_pcb]
2024-11-21 complete review of silkscreen
    [System Management Board.kicad_pcb]
2024-11-21 change TP silkscreen to stop breaking on update
    [System Management Board.kicad_pcb]
2024-11-21 reviewed zones and tracks for ordering
    [System Management Board.kicad_pcb]
2024-12-06 Started Pico power stabilizer mod board
    [Pico Power Stabilizer.kicad_pcb, Pico Power Stabilizer.kicad_sch, outline template.DXF]
2024-12-09 Pico PWR stabilizer and modified heat spreader added. Removed unused parts from enclosure.
    [0678L9100-02.SLDPRT, 0678L9250-02.SLDASM, 1843606-0.SLDPRT, 1843606.SLDASM, 187CBA5A-D168-4B29-A226-42CC7D4E3C29.SLDPRT, 1911981-16.SLDPRT, 1911981.SLDASM, 1924321-15.SLDPRT]
2024-12-09 Updated CAD with new connector plate
    [BBv3 Connector Plate Gasket.SLDPRT, BBv3 Connector Plate Gasket.STEP, Enclosure Assem.SLDASM, Enclosure Box.SLDPRT, Heatsink 266AS.SLDPRT, PM3D Multi Connector Plate.SLDPRT, PM3D Multi Connector Plate.STEP, RF174-01RP1-05BJ3-0305.SLDPRT]
2024-12-09 Removed deprecated parts
    [1 5 Pipe to Box adapter Metal.SLDDRW, 1 5 Pipe to Box adapter Metal.SLDPRT, 1 5 Pipe to Box adapter Metal.STEP, 1 5 Pipe to Box adapter.3mf, 1 5 Pipe to Box adapter.SLDPRT, 1 5 Pipe to Box adapter.STEP, 10g switch hold down bracket.SLDPRT, 10g switch hold down bracket.STEP]
2024-12-10 Finished new angle bracket for POE Switch
    [2.5GBE POE SW Angle Bracket.SLDPRT, 2.5GBE POE SW Angle Bracket.STEP, Enclosure Assem.SLDASM, Mounting plate.SLDPRT, POE SW IES3110-8TF-P.SLDPRT]
2024-12-12 Updated enclosure CAD
    [8961K15_Steel DIN 3 Rail.SLDPRT, Enclosure Assem.SLDASM, Mounting plate.SLDDRW, Mounting plate.SLDPRT]
2024-12-16 Added laser cut backing plate design that support both cabinets
    [Con Plate Jig Leg.SLDPRT, Con Plate Jig Leg.STEP, Con Plate Jig.SLDASM, Enclosure Assem.SLDASM, Jig Base.SLDPRT, Jig Base.STEP, Laser Cut Mounting Plate.SLDPRT, Laser Cut Mounting Plate.STEP]
2025-01-14 Added some tooling jigs and mounting brackets
    [C_1210_3225Metric-0.SLDPRT, C_1210_3225Metric.SLDASM, Din Rail Cable Clip.SLDPRT, Din Rail Cable Clip.STEP, Double side smd jig.SLDPRT, Double side smd jig.STEP, Enclosure Assem.SLDASM, Indicator Light Bracket.SLDPRT]
2025-03-25 Updated CCM with PSA part numbers
    [(PSA-0015) Jetson Dev Kit.SLDPRT, (PSA-0105) Enclosure.SLDPRT, (PSA-0110-Rev B) Heat Spreader.SLDPRT, (PSA-0292-Rev A) Connector Plate Gasket.SLDPRT, (PSA-0382) DIN Rail.SLDPRT, (PSA-0469-Rev A) Heatsink.SLDPRT, (PSA-0703) POE Switch.SLDPRT, (PSA-0720-Rev A) Switch Angle Bracket.SLDPRT]
2025-03-26 Updated Rev B design to include new parts for tapless connector plate and added drill templates.
    [(PSA-0105) Enclosure.SLDPRT, (PSA-0110-Rev B) Heat Spreader.SLDPRT, (PSA-0292-Rev A) Connector Plate Gasket.SLDPRT, (PSA-0469-Rev A) Heatsink.SLDPRT, (PSA-0721-Rev A) Connector Plate.SLDPRT, (PSA-0746-Rev A) Manufactured Backing Plate.SLDPRT, (PSA-0749-Rev) Indicator Light Bracket.SLDPRT, (PSA-0755-Rev A) Screw Down Cable Clamp.SLDPRT]
2025-04-21 Updated connector plate with new mounting system
    [(PSA-1317-Rev A) Backing Clamp Long.SLDPRT, (PSA-1317-Rev A) Backing Clamp Long.STEP, (PSA-1317-Rev B) Backing Clamp Long.SLDPRT, (PSA-1317-Rev B) Backing Clamp Long.STEP, (PSA-1318-Rev A) Backing Clamp Short.SLDPRT, (PSA-1318-Rev A) Backing Clamp Short.STEP, (PSA-1318-Rev B) Backing Clamp Short.SLDPRT, (PSA-1318-Rev B) Backing Clamp Short.STEP]
2025-07-10 Added Access holes for SMB removal without full disassembly
    [(PSA-0105) Enclosure.SLDPRT, (PSA-0469-Rev A) Heatsink.SLDPRT, (PSA-0469-Rev B) Heatsink.SLDDRW, (PSA-0469-Rev B) Heatsink.SLDPRT, (PSA-0469-Rev B) Heatsink.STEP, (PSA-M063-Rev B) Enclosure Assem.SLDASM]
