precision-sustainable-ag/PlantMap3D-Hardware/(notices)

Notices in the files:
parts and their libraries:
Copyright 2021 Accelerated Designs. All rights reserved.
